puji4810/coffe-scale/mechanical/optimization/README.md

# 0.3.1 与 0.3.2 同步优化

**优先保留 0.3.1 一体盘，0.3.2 作为对比候选。** 原版本和用户修改均保留。优化版用同一份最新 PCB 快照、相同底架、脚座、限位与密封方案，避免把不同底部安装条件误当成上托架的性能差异。

两版对比

## 这轮实际改动

| 项目 | 0.3.1 优化版 | 0.3.2 优化版 |
|---|---|---|
| 上部结构 | 一体盘中梁由 8 加宽至 12 mm；增加两道 4 mm 宽、6 mm 高横筋 | 保留连续宽板，四个凸台凹槽底面降低 0.2 mm |
| Z 向承压基准 | 原加载端转接板与一体盘 | 宽板上平面为承压基准；凸台底面不再抢先触底 |
| PCB 安装 | 同步实板三个 Ø2.2 孔、M2×6 与铜嵌件 | 相同 |
| 主板托盘 | 板下空隙 4 mm；托盘由四个 M3 固定 | 相同 |
| 底架 | 固定端 3 mm 垫块并入 4 mm 底架，成为一体台阶 | 相同 |
| 脚座 | 顶端嵌入底架 1.5 mm；M3×6 名义啮合 3.5 mm | 相同 |
| 向下限位 | 加 M4 锁母与 Ø5 平接触头 | 相同 |
| 抬起/横向约束 | 四个肩销与固定支耳，正常量程不接触 | 相同 |
| 外观/密封 | 保留独立显示区、玻璃、Type-C 和底盖密封 | 相同 |

主体仍为 **160 × 140 × 53.3 mm**，含侧面 USB 塞盖宽 164 mm。没有通过减少正常活动间隙来换取“刚度”。

## 0.3.1 的安装孔已同步

读取的是实时 PCB 文件，并单独保存到 [本轮 PCB 快照](references/pcb-snapshot.json)，SHA-256 为 `e73e32f7bf9a52d882affaa53008e27e2d4c2059895e2c6f3d3852744153c337`。没有改动 PCB。

| 孔 | KiCad XY / mm | 装配 XY / mm | 钻径 |
|---|---|---|---|
| MH1 | (4,4) | (61,−41) | 2.2 mm NPTH |
| MH2 | (18,37.5) | (47,−7.5) | 2.2 mm NPTH |
| MH3 | (71,37) | (−6,−8) | 2.2 mm NPTH |

PCB 仍在梁前偏右，板底 Z=11；打印托盘上表面 Z=7。使用三个 M2×6、OD3.2×4 的铜嵌件包络及对应支承台；嵌件具体型号、热熔底孔和焊盘禁碰区要按实物复核。四个托盘安装点对应底架 M3 螺纹底孔 Ø2.5。

本轮“开孔位”按 PCB 安装孔及托盘/底架配合孔处理。USB、屏幕窗口沿用已保留的 0.3.1；连接器仍是采购包络，没有借此宣称其开孔已按供应商料号定稿。

## 关键装配细节

关键剖面

### 一体固定端底架

把原先 24×30×3 的固定端垫块与底架合为一个铝件，保留传感器高度和 M6 孔位，减少一个接触界面。成品主体轨道仍厚 4 mm，局部台阶总高 7 mm，需从至少 7 mm 厚毛坯铣削；不再能仅用一张 4 mm 平板切割完成。加工成本会增加，安装平面的平面度和紧固条件仍需实物确认。

### 脚座有效螺纹

脚座上端坐到铝底架的 1.5 mm 深沉台中，保留现有 M3×6：头部支承面 Z=4，螺钉端 Z=−2，脚座顶 Z=1.5，因此名义啮合 **3.5 mm**。

模型包含盲孔钻尖，其最深处到脚座底面还留 **1.25 mm**。肩台由 0.5 加厚到 1.5 mm，脚垫由 4 改为 3 mm，使脚底仍在 Z=−8、整机高度不变。穿过底盖的位置及其密封面保持原位。材料、有效螺纹、拧紧条件和脚垫最终 SKU 仍需验证。

### 0.3.2 的凸台避空

盘底凸台最低点 Z=36，托板对应沉腔底面改为 Z=35.8；四处实际 CAD 间隙均检查为 **0.2 mm**。这样由宽板上平面接盘底承担 Z 向定位，凸台底面留空。0.2 mm 是公差设计起点，应保证最坏公差组合下仍不触底。

盘面 M4 保留原 4 mm 名义啮合，加载端 M6 保留 6.5 mm 名义啮合；未为了增加螺纹而进一步削薄盲孔上方的铝材。反复拆装时的螺纹耐久、平面贴合和预紧仍要用实物评估。

### 限位与防抬起

- 向下：保留 **0.8 mm** 模型间隙，调整柱增加锁母与 Ø5 接触鼻；金属柱底部有连接到底架的螺纹柱包络。
- 抬起：四个定制肩销的头部与固定支耳底面相隔 **1.5 mm**。
- 横向：Ø4 肩杆穿过 Ø4.8 固定孔，径向名义间隙 **0.4 mm**。
- 肩销中心位于 X=±71，Y=−9/53；肩长 12.5、上部 M3 螺纹名义啮合 3.5、头部 Ø6×3。肩台拧紧在**可动盘凸台**上，不夹紧固定支耳。

肩销是本轮定制件包络，不是宣称现成 M3 螺钉可直接替代。固定支耳、细凸台和肩销的冲击承载尚未验证。上述三个间隙都不是 LC1330 已确认的允许位移：应测正常量程、偏载、温度和公差后的实际运动，再依据厂家允许载荷/位移设定。当前刚性平移检查也不等于传感器转动、倾斜和跌落仿真。

四脚按同一平面建模，尚未增加独立调平脚；样机需检查共面度，必要时使用固定侧薄调平垫片。限位锁母需要开盖操作，本轮没有实现不拆壳的外部调整。

## 装配顺序

1. 在壳外完成加载端、转接板/宽板、铝盘的装配；检验承压面，再按胶工艺粘玻璃。
2. 把上部子装配与固定外壳对位，**底架和电子件尚未装入时**，从底部安装四个防抬起肩销。已检查 Ø6 的直线装入通路不被固定壳体螺柱阻挡。
3. 组装脚座、底盖、底架、主板托盘和电子件，从开放底部进入壳体；通过原密封检修口装传感器固定端 M6。
4. 校准向下限位、锁紧，核对肩销正常悬空与线束松弛，再装底盖密封圈、检修盖、脚垫和 USB 塞盖。

底架固定端的一体台阶改变了零件 BOM，但保留原固定端底部工具路径。肩销、上盘和电子件仍需按此顺序维护，不应把最终静态无干涉理解成任意顺序都能装入。

## 如何决定用哪版

当前优先选择 **0.3.1 优化版**：它保持单件承重盘，补筋后仍比 0.3.2 轻。0.3.2 只有在相同条件下，角部挠度、稳定时间、回零或偏载表现出现可重复且有价值的改善时，才值得承担额外重量与装配要求。

| 本轮模型计算 | 0.3.1 优化版 | 0.3.2 优化版 |
|---|---:|---:|
| 可动铝件质量 | 278.47 g | 320.21 g |
| 可动总成估算质量，含玻璃、胶及紧固件 | 359.11 g | 400.34 g |
| 中部 X=0 截面绕 Y 轴的截面二次矩，不计玻璃 | 4533.53 mm⁴ | 5154.33 mm⁴，理想完全复合 |

0.3.2 可动铝件增加约 42 g（15%）；选定截面的理想截面二次矩增加约 14%。这只是一个位置、一个弯曲方向的几何对比，且 0.3.2 依赖连接面完全传递剪力、无滑移或张开，不能据此判定整体刚度优劣。当前没有证明其有足够性能收益来替代 0.3.1。

比较时固定同一传感器、玻璃、底架、脚垫、电子件、固件、安装扭矩、温度和校准方式。中心、四角及四边中点分别加载 500/1000/2000 g，各点之间回中心，不逐点重新标定。分开记录盘面位移、称重位置差、回零、稳定时间和重复性；加测热杯与拆装复现。

本轮保存中部 X=0 截面的几何比较，0.3.2 按完全复合的理想截面计算，不能直接换成整机刚度提升或克数精度改善。结果见 [comparison.json](../exports/optimization/comparison.json)。

## 输出与复现

| 文件 | 0.3.1 优化版 | 0.3.2 优化版 |
|---|---|---|
| 完整装配 | [STEP](../exports/v031-optimized/assembly.step) | [STEP](../exports/v032-optimized/assembly.step) |
| 承重盘 | [一体盘 STEP](../exports/v031-optimized/integrated_pan.step) | [盘面 STEP](../exports/v032-optimized/pan_cover.step) |
| 宽板 | — | [宽板 STEP](../exports/v032-optimized/wide_support.step) |
| 主板托盘 | [STEP](../exports/v031-optimized/pcb_carrier.step) | [STEP](../exports/v032-optimized/pcb_carrier.step) |
| 底架 | [STEP](../exports/v031-optimized/lower_frame.step) | [STEP](../exports/v032-optimized/lower_frame.step) |
| 验证报告 | [JSON](../exports/v031-optimized/validation.json) | [JSON](../exports/v032-optimized/validation.json) |

```bash
mechanical/.venv/bin/python mechanical/optimization/model.py --variant v031
mechanical/.venv/bin/python mechanical/optimization/model.py --variant v032
mechanical/.venv/bin/python mechanical/optimization/compare.py
mechanical/.venv/bin/python mechanical/optimization/render_review.py
```

正常构建使用本轮快照。明确同步 PCB 才执行 `capture_pcb.py`，它只写本目录快照。`baseline/` 与 `v032_reference/` 是保留依赖，仅供导入；不运行其旧导出入口。原版源码校验清单在 [preserved-sources.json](references/preserved-sources.json)。

验证覆盖所有实体有效性和连通性、零件体积干涉、指定向下/抬起/横向平移、肩销安装通路、0.3.2 凸台避空、顶部剩余连续材料、底盖密封圈及承压面、天线主要铝件避让，以及 STEP 回读实体数和体积。电子件高度仍为包络；没有 FEA、密封性能、热漂、冲击强度或称重精度认证。
