puji4810/coffe-scale/mechanical/optimization/v032_reference/README.md

# v0.3.2：参考宽板结构与三孔 PCB 安装

**这是依据参考图制作的可比较版本，保留用户修改后的 0.3.1；没有覆盖旧模型、旧快照或 PCB。** 保留 LC1330、玻璃盖板、固定显示区、下沿非接触搭接、Type-C 密封件及底盖密封。

装配预览

## 这种板能否替代四叉结构

可以把窄臂托架改成连续宽板，但本项目 0.3.1 的上承重件已经是一体带筋盘，并非最早的四条平臂。因此，0.3.2 实际比较的是：

| 项目 | 用户修改后的 0.3.1 | 0.3.2 候选 |
|---|---|---|
| 上部承力结构 | 盘面、底筋同体 + 小转接板 | 连续宽板 + 独立连续盘面 + 加载端垫块 |
| 与 LC1330 的连接 | 原加载端 M6 | 同一加载端 M6，未改传感器 |
| 左右偏置 | 53 mm | 仍为 53 mm |
| 可动铝件估重 | 259.33 g | 319.84 g，约增加 60.51 g |
| 顶面与玻璃 | 连续顶面、玻璃只粘可动侧 | 保留 |
| 下底架 | 矩形减重骨架 | 沿用，局部修改主板托架螺纹底孔 |

宽板可以提供不同的弯曲、扭转载荷路径，浅铣腔保留板面连续性。但厚度、材料、孔位、板与盘面的连接平面度都会影响结果；仅凭照片不能说它比现有一体带筋盘更硬或更准。参考图没有给厚度、材料或刚度数据。

**宽板不会消除偏心力矩。** 图中总长 185，加载孔组距右端 39，因此孔组相对外形中点的偏置为 `185−39−185/2=53.5 mm`。这是托板外形中点，不一定等于原产品实际秤面中心。我们的盘中心 `(0,13.5)`、加载孔组中心 `(53,15)` 未变，3 kg 集中载荷放在盘中心时，相对孔组仍约产生 1.56 N·m 的力矩，尚未计可动自重。不能直接把该数换算成克数误差。

单点式传感器的偏载补偿与平台适用条件是传感器自身的重要特性；例如 [HBK 官方 PW2D 说明](https://www.hbkworld.com/en/products/transducers/load-cells/single-point/pw2d) 分别列出扭转刚度、偏载补偿和适用平台。这里引用其原理，不把别的型号指标当作 LC1330 的性能保证。

## 宽板尺寸与盘边支承

托板与 PCB 尺寸

图中 185 mm 长度无法直接放入 160 mm 机身，本版按结构思路重新设计，**没有等比例缩放 LC1330 孔距**。

| 项目 | 当前名义尺寸，mm |
|---|---|
| 宽板外廓 | 138 × 84，两端展开、中间连续宽板，轮廓过渡 R3；圆角会削去外廓尖点 |
| 板厚与位置 | 厚 9，Z=32..41 |
| 中部板身宽度 | 54 |
| 底部浅铣腔 | 80 × 40、深 5，R5；剩余上层 4 |
| 加载端连接 | 2 × Ø6.6，孔组间距 15，X=53、Y=7.5/22.5 |
| M6 沉孔 | Ø11、深 6.5，承压底厚 2.5 |
| 加载端垫块 | 24 × 30 × 3，Z=29..32 |
| M6 螺钉 | M6×12 圆柱头，名义进入传感器 6.5；头顶到盘底 0.5 |
| 盘面安装孔 | 四处 Ø4.4 通孔，孔距 118 × 60；中心 X=±59、Y=−15/45 |
| 盘面固定 | 从下方用 M4×8 拧入盘底一体凸台，名义啮合 4 |
| 盘面 | 160 × 113、名义顶层厚 3，下翻边沿用；局部盲孔含钻尖后仍留至少 2 mm 连续顶层 |
| 玻璃及整机 | 沿用 159 × 112 × 1.1 玻璃；主体 160 × 140 × 53.3；含 USB 塞盖宽 164 |

盘底四个凸台进入宽板的 Ø12.4、深 5 mm 定位避让腔，间隙径向 0.2 mm。盘面下表面还与宽板上平面贴合，不只是四个螺钉点承重；这种贴合是否稳定，需加工平面度与装配检验支持。M4 盲底孔直段深 5 mm，模型另包含 1 mm 钻尖，未建真实螺纹。

**支架不必伸到秤盘最外角。** 四个螺钉中心到盘外框的距离：左右各 21，前 28，后 25；它们不是全部接触面的边界。宽板实体比孔位更向外伸，剩余盘边由 3 mm 铝顶层和下翻边跨出承载。参考图那种内收支承可以采用，代价是必须检查外伸盘面的局部挠度和杯底/角部受力。

不要用玻璃单独承担悬空角载，也不能只用支架孔距判断整机四角误差。本版没有 FEA；质量增加约 61 g，也会减少 LC1330 可用净载荷余量。是否优于一体盘，需要相同玻璃、安装扭矩、载荷和温度条件下的对比试验。

## PCB：三个真实 M2 孔，梁前偏右

新快照直接读取 `pcb/scale-adc-s3/scale-adc-s3.kicad_pcb`，只写入本版本的 `references/pcb-snapshot.json`。捕获的 SHA-256 为 `e73e32f7bf9a52d882affaa53008e27e2d4c2059895e2c6f3d3852744153c337`，板外形 75 × 40、厚 1.6，三孔为 **Ø2.2 NPTH**。

坐标变换沿用 `X=65−KiCad_X，Y=−45+KiCad_Y`；板底 Z=11，板边范围 X=−10..65、Y=−45..−5。该位置使主板与 LC1330 在前后方向相隔 5 mm，左前方留给电池，显示屏仍在前部固定侧。没有为了换支架而无依据地旋转主板。

| 安装孔 | KiCad 坐标 | 装配坐标 |
|---|---|---|
| MH1 | (4,4) | (61,−41) |
| MH2 | (18,37.5) | (47,−7.5) |
| MH3 | (71,37) | (−6,−8) |

用户在 0.3.1 已加入三孔安装，本版继承并进一步调整：

- 打印托盘底板从 Z=8 降到 Z=6，板底到托盘上表面留 **4 mm**，为背面焊点和引脚留余量；实际 THT 引脚长度仍需实板确认。
- 三处 Ø5.4 支承台接触主板孔周区域，使用 M2×6 和 OD3.2 × 4 的铜嵌件包络；嵌件具体料号、底孔及热熔过盈待选型。绝缘支承环及螺钉头下方需复核 PCB 禁布区。
- 托盘自身用四个 M3×6 与 2 mm 隔柱固定到底架；对应底架孔改成 M3 螺纹底孔 Ø2.5，名义啮合 3 mm。
- 保留天线前方的结构避让。CAD 对主要铝承力件检查沿用的天线禁入体积；这不等于全部电池、线束和屏蔽件完成射频验证。
- 新快照提取了 74 个器件的二维制造层包络，纳入装配干涉检查。高度仍是预留值；连接器已插线外形、弯线半径和精确 STEP 未获得。
- J5 到侧面密封 Type-C 仍需内部短延长线，J7 接屏幕，J2 接传感器。线束不可牵拉可动盘，最终线头与走线必须再核对。

## 验证及装配

验证输出见 [validation.json](../exports/v032/validation.json) 与 [STEP 回读](../exports/v032/step-roundtrip.json)。包含全零件有效性/连通性/两两体积干涉、刚性下移 0.4/0.8、底盖密封圈及压紧面连续性、顶部剩余 2 mm 连续材料、下方 M4 工具接近路径和天线铝件避让。

传感器只是包络，移动垫块与传感器加载端的贴合面在下移检查中排除，因为真实加载端会一起移动；其他可动件对传感器包络仍检查。宽板到传感器顶部空载 3 mm，下移 0.8 后为 2.2 mm；四个止挡到盘面仍为 0.8 mm。限位值是模型初值，不是已校准的过载保护位移。

装配时先在壳外用 M6 将宽板和垫块装到加载端，再从下方用四颗 M4 固定连续盘面，随后接入底架与固定侧电子件。M4 工具通路检查不包含尚未安装的 PCB，维护时可能需要先拆主板托盘。玻璃、USB 与底盖的装配/检漏边界沿用 0.3.1。

样机应对比中心、四角和四边中点的 500/1000/2000 g 载荷、盘边位移、回零、重复性与热杯漂移；各点之间不重新标定，并在点测前后回到中心。几何检查通过不能证明更好的力矩补偿或 ±0.2 g 精度。

## 运行与文件

```bash
# 正常构建使用本版本已冻结的 PCB 快照。
mechanical/.venv/bin/python mechanical/v032/model.py
mechanical/.venv/bin/python mechanical/v032/render_review.py

# 明确要同步新的 PCB 时才执行；仍不会写 PCB 或旧版快照。
mechanical/.venv/bin/python mechanical/v032/pcb_capture.py
```

- [完整装配 STEP](../exports/v032/assembly.step)
- [宽板托架 STEP](../exports/v032/wide_support.step)
- [连续盘面 STEP](../exports/v032/pan_cover.step)
- [主板托盘 STEP](../exports/v032/pcb_carrier.step)
- [PCB 含真实孔位 STEP](../exports/v032/PCB_ENVELOPE.step)
- [修改后的底架 STEP](../exports/v032/lower_frame.step)
- [参考图](references/support-reference.png)

`base/` 保存本次开始时用户修改后的 0.3.1 源码，仅供本版导入；不应运行其中的旧导出入口。基线校验清单见 [baseline-manifest.json](references/baseline-manifest.json)。这样后续继续修改原 0.3.1，也不会悄悄改变 0.3.2 的依赖。
