puji4810/coffe-scale/mechanical/glass-and-sealing.md

# v0.3.1：在 v3 上增加玻璃、Type-C 和底盖密封

本版保留 v0.3 的一体铝承重盘、固定前显示区、下沿搭接缝和 LC1330 安装方式。玻璃仅覆盖可动盘；没有采用整机连成一片的顶盖。新增代码位于 `sealed_assembly.py`，原 `assembly.py` 和 `exports/v03/` 仍可复现 v3。

## 玻璃盖板

| 项目 | 建模尺寸 / 处理 |
|---|---|
| 玻璃 | 159 × 112 × 1.1 mm，圆角 R5.5，四周比铝盘内缩 0.5 mm |
| 底部胶层 | 0.2 mm，连续覆盖，只连接玻璃与可动铝盘 |
| 玻璃上表面 | Z=45.3 mm，比 v3 增高 1.3 mm |
| 质量 | 按密度 2.5 g/cm³ 估算约 49 g，具体值见验证报告 |
| 承力 | 玻璃 → 胶层 → 一体带筋铝盘 → 转接板 → LC1330 |

玻璃由铝盘连续支承，采用磨边、倒钝的盖板玻璃；可询价化学强化玻璃，具体牌号、工艺和厚度公差待供应商确定。化学强化用于盖板的原理见 [Corning 官方说明](https://www.corning.com/worldwide/en/innovation/the-glass-age/science-of-glass/how-it-works-strengthening-glass.html)，这里没有指定必须采购该品牌，也不把强化等同于不会破裂。

胶层按连续柔顺层预留，避免局部垫块让玻璃悬空或边缘积液。胶的模量、耐水、耐温、固化收缩，以及玻璃与铝的热变形差异需要实物联调。杯底热冲击、边缘撞击与粘接后的回零/蠕变要重新测试。**胶、玻璃均不能跨到固定屏幕面板或外壳上。** 新增可动自重也应计入传感器量程余量，去皮不会增加机械额定载荷。

## 底盖：外沿退让，内圈压紧

底盖厚 2.5 mm，Z=−3.5..−1；固定壳体底部增加连续法兰，底盖与法兰的实体接触面控制压紧终点。

- 周边密封圈外形 158 × 138、内形 154 × 134，宽 2 mm；完整闭合。
- 自由厚度暂定 1.0 mm，装配包络 0.8 mm，对应 20% 名义压缩；这个数是可修改的设计起点，**需按最终材料数据和样件压缩力确认**。
- 法兰有 0.8 mm 深槽，底盖压到实体止口后不继续挤压密封圈。需控制槽深、底盖挠曲、表面平整度和打印孔隙；不能只靠拧紧扭矩判断密封。
- 底盖外沿最外侧 0.6 mm 宽区域下退 0.3 mm，另有向外的排水退让。它们在周边密封圈之外，不直接贯通电子件内腔。
- 四处 M3×10 固定点位于 `(±72.5,±30)`，使用固定侧盲孔柱；螺钉头下另有环形密封槽和垫圈，封住位于周边密封圈内的穿孔。
- 每个脚座穿孔也单独加环形面密封。金属肩台抵住底盖的实体面，密封件装在槽内，不作为承重软垫。

四个金属脚座上端接触原铝底架、下端接橡胶脚垫，主承力路径不依赖薄打印底盖的弯曲刚度。模型保留四个脚垫 4 mm 厚，脚垫底端移至 Z=−8 mm。因此加玻璃及底盖后的 **整机总高 53.3 mm**；原 v3 为 48 mm。

脚座暂定金属车削件，中心盲 M3 孔、M3×6 螺钉名义旋入 2 mm；需要按最终脚座材料、有效螺纹和拧紧要求复核，不能直接按简化孔加工。四个底盖螺钉、四个脚座均画出穿孔密封，但具体密封件截面、硬度和压缩率尚未选定。

底盖密封并未把上方非接触称重缝变成水密封。保留 v3 的上部挡水和排水结构，整机仍需做泼溅验证，不能据此浸泡或冲洗。

## Type-C：三处需要分别处理

| 部位 | 当前模型 |
|---|---|
| 外壳与接口法兰 | 独立面密封圈，外形 18 × 13、内孔 14 × 9，装配厚 0.5 mm |
| 插座本体背部 | 要求密封封装/灌封的 USB-C 数据与供电延长组件；当前为采购包络 |
| 未插线时的口部 | 可拆硅胶塞盖，带插入段与面密封凸缘，图中是闭合压缩状态 |

沿用右侧位置，接口中心调整到 `(Y=−51,Z=16.5)`，避开壳体前角并留出完整密封面。壳体孔暂定 13 × 7；法兰 26 × 15、厚 2 mm；两颗 M2×6 沉头螺钉位于主密封圈之外，拧入壳体盲孔。固定侧局部加厚支承，不在 PCB 上开孔。

塞盖闭合时外侧到 X=84，因此主体仍为 **160 × 140 mm**，含侧面塞盖的整体包络为 **164 × 140 mm**。这种外置塞盖便于拆装，尚未做系绳或防丢铰链。插入段以压缩后的名义外形表达，实际保持力、过盈、磨损和材料硬度需实测。

这是小型密封延长件的空间目标，不是现成 USB 料号的精确 STEP。不可按本模型自行制造 USB 触点或直接下单开孔；应取得具体连接器、插头、短线和后部封装尺寸后替换 `usb_cassette_ENVELOPE`。内部线束仍接现有 PCB，线头、弯曲半径和完整走线尚未建模。

密封连接器通常分别规定配套插合状态与塞盖闭合状态，例如 [Bulgin 官方连接器说明](https://www.bulgin.com/en/products/range/pxp4043-c-series-rear-panel-mount-c-type-micro-usb-1.html)。引用仅用于说明这些状态需分别验证，不表示本模型匹配该产品的尺寸或具有其认证。**取下塞盖插普通 USB 线时，本方案不宣称防水。**

板上 USB 座 J5 实际位于机械坐标 `(X=19, Y=−10)`，开口朝 +Y（机内方向），不在任何外壁上——所以右壁插口盒必须通过内部短线转接，估算走线约 65–70 mm；线束两端固定方式与弯曲半径仍需实物规划。

## PCB 固定孔

PCB 文件已放入 3 个 M2 非金属化孔（Ø2.2 NPTH），`pcb_snapshot.py` 重新抓取后结构自动跟随——孔位若再移动，重跑 `pcb_snapshot.py` 和两个装配脚本即可，**不要手改机械侧坐标**。

| 孔位 | KiCad 原生坐标 | 机械坐标 |
|---|---|---|
| MH1 | (4, 4) | (61, −41) |
| MH2 | (18, 37.5) | (47, −7.5) |
| MH3 | (71, 37) | (−6, −8) |

- 托架在三个孔位各加 Ø5 凸台，把板从 1 mm 底板上垫起（凸台 Z=9..11，板底 Z=11）；侧边保留 1 mm 边缘定位座辅助落板。
- 螺钉按 M2×8 自攻包络建模（简化牙芯 r0.75），凸台开 Ø1.6 过孔导孔并贯通底板。若改用 M2 机牙+嵌件，凸台外径和孔径要相应调整。
- NPTH 孔周围的铜皮/走线避让由 PCB 侧保证；MH3 凸台螺钉头与 J9 包络的名义间隙只有约 0.3 mm，若 J9 选型或孔位变动需复核。
- 当前孔位是三点不对称布局，满足定位；若量产要防呆/更好支撑可再在 PCB 上调整，机械侧随快照自动同步。

## 装配与维护

1. 在壳外完成 v3 的传感器、转接板与铝盘装配，再按胶的工艺粘玻璃；检查胶没有跨接固定侧。
2. 先将 USB 面密封圈、延长组件、螺钉和内部短线装入壳体，核对面密封连续压紧；装闭合塞盖。
3. 在底盖上装脚座密封圈和金属脚座，将铝底架用脚座螺钉固定，再装电子件；脚座固定后检查底盖可拆性与线束余量。
4. 将周边圈放入壳体槽内，装底盖和四颗带头下密封的 M3 螺钉，逐步对角压到止口。
5. 调整限位、检查自由回零；最后装脚垫并进行检漏、热杯和九点称重试验。

当前只检查最终装配和指定直线间隙，不是全装配路径仿真。打印外壳需对密封面精加工或采用经验证的后处理，平面密封圈、脚座密封和接口密封应能拆换。没有提供量产拧紧扭矩或防水等级。

## 复现与输出

```bash
mechanical/.venv/bin/python mechanical/sealed_assembly.py
mechanical/.venv/bin/python mechanical/sealed_assembly.py --frame butterfly
mechanical/.venv/bin/python mechanical/render_sealed.py
```

当前输出目录：`exports/v031/{rectangle,butterfly}/`。装配 STEP、玻璃、底盖、修改后的壳体/底架、密封件与 USB 包络分别导出；旧 v3 输出保留不覆盖。

验证包括：全部零件实体有效性、连通性、两两体积干涉；可动件下移 0.4 / 0.8 mm 后的固定件干涉；原天线铝件避让；周边密封圈连续性与上下支承面；STEP 回读实体数和体积。密封件按压缩状态建模，这些检查不能证明密封压力、无泄漏、玻璃强度或称重准确度。
