puji4810/coffe-scale/mechanical/pan-design.md

# v0.3：连续顶面的一体带筋承重盘

盘面、底筋和下翻边由同一块铝材加工，顶部不留贯穿螺钉孔。下翻边包住固定壳体内缩的挡水立边，让活动开口朝下；前缘覆盖与固定显示区的分界。

一体盘正反面

## 1. 结构与高度

| 项目 | 候选尺寸，mm |
|---|---|
| 秤盘平面 | 160 × 113，外圆角 R6；X=−80..80，Y=−43..70 |
| 盘体总深 | 11，Z=33..44 |
| 连续顶层 | 厚 3，Z=41..44 |
| 加强区域 | 134 × 96；底面铣腔深 8，保留周边筋、中梁和加载端安装台 |
| 下翻边 | 厚 2，高 5，Z=36..41，与顶层同体 |
| 转接板 | 28 × 56 × 4；中心 (53,15)，Z=29..33 |
| LC1330 | Z=7..29，外形与原孔型不变 |
| 固定端垫块 / 底架 | Z=4..7 / Z=0..4 |
| 脚垫 | Z=−4..0；整机总高 48 |

铝材候选为 6061-T6；薄顶层加工平面度、装夹和残余应力处理需加工方确认。所有深度均是概念名义尺寸，尚未出含公差的加工放行图。

按 CAD 实体体积、密度 2.70 g/cm³ 估算，盘体 **243.82 g**，转接板 **15.50 g**，合计 **259.33 g**。旧 v0.2 的秤盘、托架、垫块合计 303.77 g，本版减少 **44.44 g**，均不含紧固件。记录见 [pan-review.json](exports/v03/pan-review.json)；旧体积基线独立保存在 [v02-mass-baseline.json](references/v02-mass-baseline.json)，重新构建不依赖旧 STEP。

## 2. 把活动缝藏到下沿

挡水剖面

固定壳体顶面 Z=33，其上有一圈连续内缩立边，外形 152 × 105、壁厚 2、顶高 Z=38.5。外侧可动下翻边的底端 Z=36，形成无接触搭接。

| 间隙 | 空载模型 | 刚性下移 0.8 mm 后 |
|---|---:|---:|
| 下翻边内面到固定立边外面 | 2.0 | 2.0 |
| 下翻边底端到固定台阶 / 前面板 | 3.0 | 2.2 |
| 盘顶层底面到固定立边顶端 | 2.5 | 1.7 |
| 两道边的竖向遮挡重叠 | 2.5 | 3.3 |

侧面和后部的排水缺口位于内圈立边之外，实体检查确认没有切断内圈挡水边。图中蓝箭头表示期望的排水方向，未模拟水的附着、飞溅或毛细作用。

前方屏幕区域仍然固定，顶部另有一张 **152 × 28 × 0.3 mm 连续 PC 覆膜**，下面是 0.2 mm 闭合周边胶圈。覆膜覆盖屏幕和按键开口，只粘固定面板；后缘位于秤盘前缘下方，分界从上方被遮住。膜片按键组件、背面支撑和胶粘工艺待实物选型，按键接已有 J8；模型没有因此改 PCB。

**不能把整张膜、胶或橡胶圈跨接可动盘和固定面板**，否则会形成额外传力路径。连续秤面和非接触搭接用于降低上方泼水直接进入的机会，不等于水密封。USB 延长接口目前仍有开口，底盖和其他接缝也未完整密封，需完善后做实物泼溅、积液和清洁测试。

## 3. 顶部无孔，怎样安装

保留传感器原 M6 螺纹，用小转接板把传感器安装与秤盘安装分成两道连接。

| 连接 | 数量 / 候选螺钉 | 孔和名义啮合 |
|---|---|---|
| 转接板 → LC1330 加载端 | 2 × M6×12 圆柱头，从上拧入 | 转接板 Ø6.6 通孔，穿过 4 mm 板后名义啮合 8 mm |
| 转接板 → 一体盘 | 4 × M4×10 圆柱头，从下拧入 | 转接板 Ø4.4 通孔，盘底 M4 盲孔，名义啮合 6 mm |
| LC1330 固定端 → 底架 | 2 × M6×16 沉头包络 | 沿用固定端垫块和底架，实际头型、孔深和啮合需确认 |

盘底为两颗 M6 螺钉头预留 Ø11、深 6.5 的盲腔，腔顶至盘顶保留 4.5 mm；螺钉头与腔顶名义间隙 0.5 mm。四个 M4 孔中心是 `(47,−7)、(47,37)、(61,−7)、(61,37)`，直段底孔 Ø3.3、深 7，有效螺纹候选深 6.5。直段底孔上方还有 4 mm 材料，另预留约 1 mm 钻尖空间；加工方需核对实际钻尖和丝锥退刀需求，保证连续顶层不被钻穿。

螺纹在 CAD 中简化，实体不相交并不能验证螺纹承载、拧紧扭矩或拉脱强度。LC1330 外形与孔位来自 [厂家尺寸图](https://www.labloadcell.com/uploads/13301.jpg)，本地有 [原图](references/lc1330-dimensions.jpg)；固定端、加载箭头和孔内实际可用深度以手头实物为准。

### 装配顺序

1. 在壳外，把转接板用两颗 M6 固定到 LC1330 加载端。
2. 将一体盘盖到转接板上，让 M6 螺钉头进入盘底盲腔；翻转并从下方拧入四颗 M4。该步骤在 PCB 和底架安装前完成，CAD 已检查直径 5 mm 的直线工具接近通路。
3. 将盘 / 传感器子装配固定到铝底架的固定端垫块，从底部安装固定端螺钉。随后从开放底部装入电子件和外壳组件；显示覆膜可先在壳体上粘好。
4. 安装线束并保留传感器出线松弛弯，完成限位调整后再装脚垫与待设计底盖。主板最终卡扣、线头和壳体装入路径仍需样机核对。

前排 M4 下方有主板区域，维护时需要先拆电子件，不能把上述壳外工具通路理解为整机不拆卸即可维修。

## 4. 已检查与待实测

当前默认矩形底架和四叉底架对照装配均有 45 个有效实体，无体积干涉；STEP 回读实体数和体积一致。一体盘完整 3 mm 顶层、四处 M4 安装台、连续挡水边、前覆膜及壳外工具通路检查通过。刚性下移 0.4 / 0.8 mm 未碰到固定零件，0.8 mm 时止挡接触盘底。

0.8 mm 是限位布局初值，必须根据实物空载、满载中心 / 四角位移、公差及厂家允许过载位移调整，并落实锁紧。当前未设计抬起限位、横向冲击保护或运输锁；刚性平移检查不包含实际传感器旋转和盘体挠曲。

保留 LC1330 意味着加载端仍偏置 53 mm。一体带筋盘减少连接面，但不消除力矩，也没有证明达到 ±0.2 g；仍需按 [README 的九点测试](README.md#受力与验证边界) 检验整机偏载、重复性和回零。
