puji4810/coffe-scale/mechanical/support-design.md

# 上托架 v0.2：一体铣削带筋托盘

> 历史对照：当前方案已改为顶面无孔的一体承重盘，见 [v0.3 设计](pan-design.md)。本文与 `exports/upper-support/` 保留旧版独立秤盘结构，不作为当前装配尺寸。

## 设计结果

采用 **6061-T6 铝合金一体加工托盘**，上表面支承独立秤盘，底面两个连通轮廓的减重腔保留周边筋、中梁、加载端安装区域和四个秤盘螺钉安装台。没有额外接触固定底座；传感器加载端位置不变，偏心力矩仍然存在。

| 项目 | 候选尺寸 / 结构 |
|---|---|
| 托架外形 | 134 × 96 × 10 mm，外圆角 R6 |
| 上层厚度 | 3 mm |
| 底面铣腔 | 深 7 mm，所有平面轮廓内角 R3 |
| 周边筋 | 宽 4 mm，位于上层下方，高 7 mm |
| 中梁 | 宽 8 mm，同样高 7 mm；与上层形成局部 T 形截面 |
| 传感器连接 | 右侧两颗 M6，组内距 15 mm；下方保留 24 × 30 × 3 mm 垫块 |
| M6 安装孔 | Ø6.6 通孔，上面 Ø11 沉孔深 6.5 mm；承压底厚 3.5 mm |
| M6 螺钉 | 圆柱头 M6×16，简化头 Ø10 × 6 mm，名义啮合 9.5 mm |
| 秤盘固定 | 四颗 M3×8 沉头螺钉，孔距 122 × 84 mm；简化 Ø6 螺钉头低于盘面 0.5 mm |
| 托架 M3 孔 | M3×0.5，有效螺纹深 6 mm；Ø2.5 直段底孔深 8 mm |
| 秤盘孔 | Ø3.4 通孔，上面 Ø7、深 1.8 mm 的 90° 沉孔包络 |
| 整机尺寸 | 160 × 140 × 49 mm，比 v0.1 高 7 mm |

螺钉都用简化包络：螺纹、内六角和钻尖未建立。上托架 M6 头径参考 [Bossard 头部承压尺寸资料](https://www.bossard.com/nl-en/-/media/bossard-group/website/documents/technical-resources/en/f-040-en.pdf)；M6 圆柱头高度 6 mm 可在其 [ISO 4762 产品 CAD 目录](https://bossard.partcommunity.com/3d-cad-models/bn-31101-5403310-socket-head-cap-screw-m6x10-bossard-catalog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)核对。订购时仍以具体型号的头部公差、实际长度和传感器孔深确认装配。

### 为什么选这种形状

原四臂把 3 mm 平板沿长度方向悬伸，长臂对竖向载荷容易产生较大挠度。新托架用更深的截面，同时通过连续上层和周边结构连接四个支撑位置，增加分担载荷的路径。中梁从左侧延伸到右侧安装区域，周边筋把前后区域连接起来。

这仍是**底面开口的带筋托盘**，不宣称它是完整的闭口扭转箱。秤盘虽然固定在其上面，但计算时没有假定两者形成无滑移的复合板，也没有计算整体抗扭刚度。

一体铣削比单独焊接筋条更容易控制这个小尺寸件的安装面和装配关系。折弯件可以作为后续成本方案，但需要重设计接头、弯曲半径、避空和加工基准，不能直接把此 STEP 当作钣金展开件。

## 质量与截面对照

由实际 CAD 体积、假定密度 2.70 g/cm³ 计算：

| 方案 | 托架估算质量 | 说明 |
|---|---:|---|
| 原 3 mm 平板四臂 | 37.69 g | v0.1 几何原样保留 |
| 6 mm 平板四臂 | 76.04 g | 只作单件比较，没有集成到整机 |
| 新 10 mm 带筋托盘 | 171.63 g | 默认装配方案，比原托架重约 133.94 g |

这个版本优先探索更高刚度，尚未优化到最轻。增加的可动质量会占用传感器量程；加上秤盘、垫块和螺钉后，不能再把 3 kg 传感器当成允许额外放满 3 kg 的整机。去皮也不会恢复机械量程。

`support_review.py` 另计算局部竖向弯曲截面的面积惯性矩 I：

- 13 mm 宽 × 3 mm 厚平条：I = 29.25 mm⁴。
- 13 mm 宽 × 6 mm 厚平条：I = 234.00 mm⁴。
- **人为选取** 13 × 3 mm 上翼缘 + 8 × 7 mm 下筋的局部 T 形条：I ≈ 832.65 mm⁴。

计算使用矩形自身惯性矩 `b h³/12` 与平行轴项 `A d²`。在相同材料、长度和边界条件下，梁弯曲刚度与 I 成正比；这里的 13 mm 上翼缘宽度只是统一比较口径，并非板有效宽度分析。因此 **28.47 倍只是所选截面 I 的比值，不能称为整机刚度提高 28 倍，更不能换算为克数误差**。

尚无 FEA、网格收敛、角载挠度、局部承压、螺纹拔出或疲劳验证；也没有宣称四角误差达标。

## 加工与装配

1. 毛坯留精加工余量，加工上下基准面；成品托架总厚 10 mm。
2. 从底面铣两个深 7 mm 的腔，保留中梁、周边筋及四个斜角安装台。内角 R3 可供 Ø6 或更小刀具进入；轮廓已避免相邻口袋相切留下的薄尖筋。实际刀路、根部刀尖圆角与去毛刺由加工方确认。
3. 从上面加工 M6 通孔/沉孔和 M3 盲螺纹孔。M3 的 8 mm 底孔深度指直段，另考虑钻尖和丝锥退刀空间，禁止钻穿安装台。
4. 精加工秤盘接触面及传感器垫块接触面；接触面不得有毛刺、涂层堆积或靠拧紧螺钉强行拉平的翘曲。平面度、平行度与表面处理公差尚待加工图定稿。
5. 先安装传感器固定端与下垫块，再将右端上垫块和托架用两颗 M6 圆柱头螺钉固定。秤盘尚未装入时，内六角工具从上方进入。
6. 放上独立秤盘，以四颗 M3×8 沉头螺钉固定。当前 Ø6 简化头部与 Ø7 沉孔相配时，下沉 0.5 mm 后贴合锥面；名义进入托架 5.5 mm，小于 6 mm 有效牙深，底孔另留余量。实际头径变化会改变沉入深度，需核对避免顶到孔底。
7. 统一装配后检查间隙，再通过加载试验调整和锁定四个限位。

不要沿用任意扭矩表直接拧紧：M6 拧紧条件需同时满足 LC1330 供应商要求及托架局部承压能力。更换螺钉头型、加垫圈或表面处理会改变当前 0.5 mm 的头顶余量，应重新校核。

## 当前验证结果

两个底架版本均使用新托架，通过：

- 44 个实体的有效性、单件连通性及两两实体干涉检查。
- 可动组件整体下移 0.4 mm 和 0.8 mm 时，与固定件无体积相交。这是装配行程检查，不是受力仿真。
- 托架到传感器本体：静态 3.0 mm；下移 0.8 mm 后仍有 2.2 mm。
- 秤盘到固定外壳最小距离 2.0 mm；限位空载间隙 0.8 mm；M6 螺钉头顶到秤盘 0.5 mm。
- 主板/接插件占位与新结构无体积相交，铝件没有进入当前天线避让体积。
- M3 孔周围保留完整深度的材料、底孔封闭；装秤盘前 M6 工具路径畅通。
- 导出整机 STEP 后回读，实体数、有效性和总体积一致。

0.8 mm 限位仍是占位设定，电子件仍是包络。线束、胶层、实际公差和传感器运动形态尚未包括在验证中；最终需按 README 的九点测试计划验证偏载、重复性与回零。

## 文件与复现

- `upper_support.py`：托架几何，保留 `flat_reference()` 作为原版对照。
- `dimensions.py`：`upper_*` 参数、安装点及随托架厚度更新的整机高度。
- `exports/rectangle/upper_spider.step`：默认新托架单件；使用旧文件名以延续装配引用。
- `exports/rectangle/assembly.step`：新版完整装配。
- `exports/upper-support/ribbed_10mm.step`：明确命名的新托架单件。
- `exports/upper-support/support-comparison.png`：原四臂与新托架底面预览。
- `exports/upper-support/support-drawing.png`：底面特征投影、截面和孔位审阅图。
- `exports/upper-support/comparison.json`：质量、局部截面计算与安装台检查结果。

```bash
mechanical/.venv/bin/python mechanical/assembly.py
mechanical/.venv/bin/python mechanical/assembly.py --frame butterfly
mechanical/.venv/bin/python mechanical/support_review.py
mechanical/.venv/bin/python mechanical/render.py
mechanical/.venv/bin/python mechanical/render_support.py
```

所有修改位于 `mechanical/`，PCB 继续使用已存只读快照。
