puji4810/coffe-scale/mechanical/optimization/v032_reference/structure-review.md

# 0.3.1 / 0.3.2 结构复核

## 结论

0.3.2 具有提高局部抗弯截面性能的潜力，不能据此宣称整机刚度或称重性能更好。0.3.1 已是一体带筋盘，不是最早的薄四叉臂。0.3.2 的两件大平面连接、偏载扭转和下底架响应尚未验证。

### 当前 CAD 的局部截面计算

在 X=0 取 0.1 mm 均匀薄片，从 CAD 体积惯性矩换算截面二次矩 I_y，衡量该处沿 X 方向承受竖向弯曲的几何抗弯能力；同材质局部梁近似中 EI 与它成正比。

| 截面 | I_y / mm⁴ |
|---|---:|
| 0.3.1 一体带筋盘 | 3908 |
| 0.3.2 宽板单件 | 1504 |
| 0.3.2 连续盘面单件 | 598 |
| 0.3.2 两件完全复合的理想截面 | 5154 |

两件完全复合时，此截面指标约增加 32%，可动铝件从 259.33 g 增至 319.84 g（增加约 23%）。这是局部的理想化几何比较，不是整机刚度提高 32%，也没有证明重量效率更高。两件各自截面 I 相加为 2102 mm⁴，仅用于说明复合作用的重要性，不是实际装配刚度下限。

真实连接可能发生接触面的开合、微滑和不均匀承压；四角加载还涉及扭转与板弯曲。玻璃与胶层、螺钉预紧、传感器弹性和下底架没有进入该截面计算。极惯性矩也不能直接当作这种开口薄壁结构的扭转常数。

复现：`mechanical/.venv/bin/python mechanical/v032/section_review.py`。数据见 [section-review.json](../exports/v032/section-review.json)。没有修改任何 CAD 尺寸。

## 优先改善项

### 1. 明确托板与盘面的唯一 Z 向承压基准

当前盘底凸台高度 5 mm，托板沉腔深度也为 5 mm；设计同时要求宽板上平面贴盘底、四个凸台端面贴沉腔底。加工公差或翘曲可能让凸台先触底，导致本应大面积接触的平面悬空。

建议以宽板上表面的指定平面承压，凸台只用于螺纹连接和侧向避让，底面留出额外轴向空隙。可从 0.1–0.2 mm 的名义避空开始做公差链，最终数值由加工能力确定；不能简单把四处都做零间隙。螺钉预紧、平面度、贴合检查及装配后回零需写入装配要求。

若希望结构最可预测，可将宽板思路融合回一体带筋盘，减少这处大面积螺接界面的不确定性。是否采用取决于加工成本和样机对比，不因新版本编号而默认它更优。

### 2. 加强材料分布，先检查固定端底架

优先研究保留较高的周边筋、加载端到远端的连续筋，以及靠盘前后边缘的纵向承力路径，再决定哪里减重。不要为了减重挖断扭转载荷路径，也不要把整片继续加厚作为唯一手段。

固定端 24×30 mm 垫块、4 mm 铝底架、底架开窗附近与脚座连接需要一起评估。刚度不足或安装面不平会改变安装状态；[HBK 的载荷引入与支承说明](https://cloud.hbkworld.com/en/knowledge/resource-center/articles/load-application-in-load-cells) 强调安装接触点和刚性基座的重要性，具体 LC1330 扭矩仍应使用其供应商要求。

四脚结构需保证共面，或提供调平能力，避免在不平台面上靠扭曲底架实现四脚接触。这里不把打印底盖或软密封圈作为传感器主支承。

### 3. 核实紧固件有效啮合与加工面

当前模型名义值：盘面 M4 啮合 4 mm、传感器加载端 M6 啮合 6.5 mm、金属脚座 M3 啮合约 2 mm；M6 沉孔承压底厚 2.5 mm。这些都只是几何候选。

优先增加脚座可用有效螺纹长度，并按实际材料、孔深、钻尖/丝锥退刀和螺钉头标准复核。盘面频繁拆装时可评估钢丝螺套或更深的螺纹台，但不应侵入玻璃粘接面。不要把其他厂家的 M6 拧紧扭矩套用到 LC1330。

### 4. 限位从占位尺寸变成可调、可测结构

0.8 mm 当前只是 CAD 间隙，没有来自传感器满载位移。需要先测带盘自重时的空载、满载中心与四角位移，再在正常位移和公差余量之外设止挡，并确认小于允许过载位移。

除向下止挡，还值得补充抬起和横向碰撞保护；所有保护件在正常称重时保持不接触，避免旁路支撑。锁紧、装配可达性和运输保护一起考虑。

### 5. 热、线束与密封的寄生作用

玻璃、铝盘和胶的热变形差异、热杯传热、胶层蠕变都需在装配后测试。避免把硬胶或密封件跨接可动盘和固定壳体；传感器线留松弛弯并在固定侧应力释放。即使没有实体碰撞，线束牵拉仍可能影响回零。

底盖和 USB 接口密封保持在固定侧。当前主板三个真实 M2 孔和 4 mm 板下净空可作为布局基线，下一步按实际插头、THT 焊脚和线束弯曲半径校核，不需要为了加刚度盲目挪板。

## 验证顺序

1. 先处理承压基准、脚座螺纹和实物安装条件，再比较结构；否则仿真边界本身不明确。
2. 统一材料、玻璃、载荷和安装方式，比较中心及四角加载下的盘面位移、扭转和固定端底架变形。先可做固定加载端的结构相对比较；要预测整机，需加入传感器柔度和接触/预紧。
3. 原型测试分开记录几何位移与称重偏差。采用相同砝码、相同位置、统一标定，逐点回中心、卸载回零，并进行热杯和重复拆装试验。

刚度提高不等于偏载误差按相同比例下降，也不能仅凭 CAD 无干涉声明 ±0.2 g 已达成。
