puji4810/coffe-scale/pcb/s3.1/LOW_POWER_NEXT_REV.md

# 下一版 PCB：电源架构——真关机、待机功耗与可测量

2026-10-05：按用户要求，此次不改现有 s3.1 原理图、PCB、BOM 或 Gerber，也不做飞线。本文记录下一版的设计输入，不是已完成的可生产电路。

2026-10-10：范围扩展为整机电源架构：三种供电状态、总电源闩锁（真关机按钮）、待机漏电逐项清理、板载电流测量入口；TMP102 从 BOM 移除。本文仍是设计输入，未执行任何原理图/PCB/BOM 修改。

## 三种供电状态

| 状态 | 供电 | 退出方式 | 目标电池端电流 |
| --- | --- | --- | --- |
| 运行 | 全部轨 | — | 实测记录（背光/BLE 主导） |
| 待机 | 模拟轨切断，MCU deep sleep | 双击 INT1（IO13）/ MODE（IO18） | <100 µA |
| 关机 | VSYS 全断（两个 LDO 输入之前） | 仅电源键开机 | <5 µA（电池包保护板自耗除外） |

关机后双击唤醒、RTC、充电指示全失效——这是"真关机"的语义，与待机区分开。插 USB 应自动开机，保证充电和烧录不依赖按键。

## 当前限制

U7 HT7533 的输入直接接 VSYS。其输出 VDD_ADC 同时供 NAU7802 的 DVDD/AVDD/REFP、TMP102、J2/J11 的 E+。NAU7802 的 PUD/PUA 关闭只停止芯片内部工作，不切断电桥激励。

当前原理图注释采用 LC1330 输入电阻 410±10 Ω 的预算；若实装该型号，单桥在 3.3 V 下约 8 mA，双桥约 16 mA。实装电阻仍需确认。

J6 直挂 VSYS，没有任何电源开关：最深的低功耗态就是深睡，整板 ~10 mA 量级，"关机"只能靠拔电池。

TMP102（U3）即便实装，测的也是 PCB 上的空气温度，与电桥本体温度的对应关系很差，对温漂补偿没有价值——下一版从 BOM 移除。固件已容忍缺席（上电探测一次，读不到即关闭 thermal comp，不再轮询死地址）。若以后仍要温度数据，物理上正确的位置是电桥本体：J11/ch2 接 PT1000 贴传感器做比率测量（README 已预留此用法），而不是再放一颗板温计。

深睡下其余嫌疑漏电源（按估算量级排序）：

- 电桥激励：单桥 ~8 mA（410 Ω @3.3 V）——第一大头，靠模拟轨开关消灭。
- U6 XC6220B331 静态电流：高 PSRR LDO 的 Iq 在数十~百 µA 量级（随后缀与工作模式，需核对规格书），深睡下是第二大头。
- R13/R14 VBAT 分压 100k+100k 常挂电池：4.2 V 下 ~21 µA。
- N16R8 模组内 flash + 八线 PSRAM 的待机电流；深睡能否关 VDDSDIO 待验证。
- LCD 模块自身漏电：SLPIN 已发，但模块上背光 MOS/外围元件的静态电流不可控。
- TTP223 触摸模块（若 MODE 走触摸）：~4 µA，作为唤醒源保留供电。

## 必须落实的电路要求

### 总电源闩锁与关机

1. **切断点在 VSYS、两个 LDO 输入之前。** 关机 = 电桥/传感器/LCD/MCU 全断；EN 拉低这类"软关"不算——LDO 与外设仍然耗电。
2. **闩锁定稿：LTC2955**（2026-10-10 调查定稿）——按键开关控制器，覆盖全部需求：
   - VIN 1.5–36 V、Iq 1.2 µA，供在 VSYS 节点（任一电源在位即有电），关机预算内占 ~1.2 µA；
   - **ON 脚 = 电压监测自动开机**：接 VBUS 网即实现"插 USB/EXP_5V 自动开机"；**必须 RC 微分耦合只取上升沿**——ON 脚下降沿也能触发关机，直连的话电池供电下拔 USB 会误关机；
   - **INT → MCU**：按键通知，给收尾窗口；**KILL ← MCU**：确认断电。长按超 TMR 定时强制断——死机兜底；TMR 外接电容定时（C_TMR ≈ 0.19 µF/s，目标 ~2–3 s）；
   - **-2 后缀 EN 直接驱外部 P-MOSFET** 切 VSYS（-1 为高有效 EN，驱 LDO/负载开关场景）；PB 口 ±36 V、±25 kV ESD，可直接挂 J8 按键线；
   - 封装 TSOT-23-8（LTC2955ITS8-x）或 DFN-10；ADI/Linear 料 LCSC 有售，下单前核现货单价。
   备选淘汰记录：MAX16150（VCC 上限 5.5 V 贴 VBUS 5.25 V 裕量不足；关断定时固定 8/16 s；无电压监测自动开机）；双 MOSFET 软闩锁保留为兜底备选。
3. **按键复用**：MODE 兼电源键，接 IC 的 PB 脚，同时仍驱 IO18。关机态按下 = 开机；待机态短按 = 唤醒（维持现状）；运行态长按（~2–3 s）= 关机。**断电即全部清空**：不保留计时/去皮/模式等运行态，仅 NVS 校准存活（2026-10-10 改定）。
4. **VBUS 自动开机（边沿语义）**：USB（机器形态 EXP_5V 经 D3 反灌）接入时自动上电。TP4057 在闩锁上游，关机充电不受影响。注意 CHRG_STAT 上拉侧：关机充电时不能经 IO8 输入保护结构反灌整板。
5. **关机漏电预算**：LTC2955 自身 1.2 µA + 闩锁 PMOS 关断漏电 + INA226 shutdown + 按键路径 + 任何挂在 BAT+/VSYS 的常接负载，合计 <5 µA（电池包保护板自耗除外）。

### 机器形态（J10 / EXP_5V / D3）交互

- **EXP_5V 与 USB 等价**：D3 落地后 EXP_5V 灌在 VBUS 网上，经 D1/Q1 进 VSYS、经 TP4057 给电池充电，与插 USB 无法区分。自动开机触发点放在 VBUS 网，两个来源天然共用。
- **闩锁控制器供电取 VSYS 节点**（任一电源在位即有电）：机器形态无电池、无按键时靠 EXP_5V 供电并自动开机——机器上电 = 本板上电，正好替代缺失的按键。
- **自动开机为边沿语义**：电源从无到有触发一次；电源保持期间长按仍可关机并保持关（直到按键或电源重新接入）。不用电平保持式，否则插着线永远关不掉；机器侧想强制运行就循环 EXP_5V，本身就是硬重启。
- **D3 保持 B5819W 二极管 OR**：防 USB VBUS 反灌机器侧 5 V 母线，~0.3 V 压降下 TP4057 仍可充电；0R 直通等于双 5 V 源并联，仍不贴。
- **J10 pin20 EN 仍是复位**，不是开关机；机器侧重启本板用 EN 或循环 EXP_5V。
- **关机反灌窗口**：本板断电而机器侧带电时，UART 空闲高、I2C 上拉、XIO 高电平经 IO 保护二极管向 3V3 轨偷电——100R 串阻只限流（每脚最坏 ~26 mA）不阻断，可把 MCU 顶在半供电僵尸态。约束给机器侧：本板断电期间 J10 驱动必须高阻。固件侧缓解：检测到充电/外部供电在位时直接忽略长按关机。
- **远程关机通知（已定需要）**：机器侧经 J10.18/19 UART0 发关机请求（协议字节随机器协议定；XIO 专用线为备选）→ 固件收尾后拉 KILL **自切电源**——时序可控，比"预警后等掉电"干净；机器侧直接硬断 EXP_5V 也可接受：断电即清空、无非正常态，仅失去收尾机会。

### 模拟轨断电（沿用 2026-10-05 要求，TMP102 移除后修正）

6. **可控模拟供电。** 在 U7 输入前增加高侧负载开关，或换成合适的低静态电流带 EN 的 LDO。由 GPIO 控制，外部下拉保证复位和深睡默认关闭。额定输入要覆盖 USB 供电下的 VSYS；不要用只允许 3.3 V 输入的器件接这里。可评估 [TPS22919](https://www.ti.com/lit/ds/symlink/tps22919.pdf)（1.6～5.5 V，主动高 ON）；需要进一步核对封装、采购与整板压降预算。
7. **整轨切换。** AVDD、DVDD、REFP 与 J2/J11 E+ 一起受控，仍保持 NAU7802 外部 AVDD、内部 LDO 关闭。不要只切 E+ 而将 REFP 留在未切换轨上，否则开关压降不再由比率测量抵消。TMP102 已移除，受控侧外设只剩 NAU7802。
8. **I²C 断电隔离。** NAU7802 放在受控支路，LIS2DW12 留在常供电支路。SDA/SCL 必须采用经断电条件验证的隔离方案（PCA9306/TCA9509 类总线开关为候选），防止 3V3 侧上拉通过输入保护结构反向供电；受控侧上拉接 VDD_ADC。关断时共享总线仍应能与 LIS2DW12 通信。不能只加电源开关、保留原共享上拉连接。
9. **逐信号查反灌。** 核对 DRDY、ALERT、参考/输入以及外接 J11 设备是否存在其它电源来源。外设关断时 MCU 引脚必须为适当输入/高阻；禁止从 MCU 输出高电平给未供电器件。
10. **独立保留唤醒电源（待机态）。** LIS2DW12、MODE 按键/触摸模块、ESP RTC 待机时保持供电；关机态这些也断。**LCD 定稿独立负载开关 LCD_EN**（2026-10-10 定）：切 J7.2 模块 VCC，背光随灭；其 SCK/MOSI/CS/DC/BL 要检查反灌及默认电平，切前固件把各线置安全电平或高阻（见固件顺序）。

### 待机漏电逐项

11. **主 LDO 换低 Iq。** XC6220 换成 Iq <~30 µA、峰值 ≥500 mA（顶 BLE 发射峰值）的 LDO；候选方向 HT7833 / TLV755P / RT9013 一类，实贴前核对规格书、封装与采购。
12. **VBAT 分压。** 留在 BAT+（保留充电时读真实电池电压的能力），电阻改 1 MΩ+1 MΩ、中点并 100 nF 到地压低 ADC 源阻抗；~2 µA 计入关机漏电预算。**若 INA226 实装则此分压可省**（INA226 自带总线电压测量），DNP 板仍需要。要彻底清零可 PMOS 门控，复杂度换 2 µA，一般不划算。
13. **VDDSDIO 深睡断电（固件项）。** `esp_sleep_pd_config(ESP_PD_DOMAIN_VDDSDIO, OFF)`；N16R8 模组 flash/八线 PSRAM 的实际节省与可行性要验证，确认 RTC 保留数据不受影响。

### 可测量

14. **总电流入口**：BAT+ 与闩锁之间放常闭焊盘跳线 JP_IBAT（出厂连通）。剪开后可串万用表电流档，或焊 0.1–1 Ω 电阻量 mV；跳线两端留 2.54 mm 间距测试点方便挂表笔。量产板跳线保持连通。
15. **模拟支路入口**：ANALOG_SW 输出（或 U7 输入）侧同法放 JP_IADC，区分模拟轨与数字轨的消耗。
16. **电压测试点**（板边一排，丝印标名）：VBAT、VSYS_SW、3V3、VDD_ADC、ANALOG_EN、PWR_EN/PWR_HOLD、VBUS、CHRG_STAT、EN。
17. **INA226 电流计（定稿保留，2026-10-10 定）**：串在电池线高侧（JP_IBAT 位置），挂现有 I2C，`p` 命令读真实电流与总线电压。自身耗电（运行 Iq 数百 µA 级、shutdown µA 级，核规格书）计入待机/关机预算；待机进入 deep sleep 前固件置其 shutdown。注意它落在闩锁上游，关机态仍在位，靠 shutdown 控功耗。

### 引脚分配

18. ANALOG_EN 候选 IO2（NC、非 strapping），外部 100 kΩ 下拉保证上电默认关，更新 `board/pins.hpp`；IO14 在 J10 机器扩展用途不动。PWR_HOLD（或 IC 的 KILL/INT）与可选 LCD_EN 引脚随原理图定稿分配。

## 待机功耗预算（目标，不是承诺）

| 项 | 估算 |
| --- | --- |
| ESP32-S3 深睡（含 RTC） | ~10 µA |
| flash/八线 PSRAM 待机 | ~0（VDDSDIO 可断）– ~200 µA（不可断） |
| LIS2DW12 400 Hz 双击检测 | ~10–20 µA |
| 主 LDO Iq | ~2–25 µA（视选型） |
| VBAT 分压（1 MΩ/1 MΩ） | ~2 µA |
| 模拟轨关断漏电 | <1 µA |
| 闩锁 IC LTC2955 | ~1.2 µA |
| INA226（shutdown） | ~µA 级，实测 |
| TTP223（若实装） | ~4 µA |
| **合计** | **~30–250 µA**，目标 <100 µA |

对照：s3.1 深睡 ~10 mA、1000 mAh 电池约 4 天；100 µA 下理论待机超过一年。运行态功耗不受以上改动本质影响（LDO 是线性的，效率不变）。

## 对应固件顺序

待机：停止采样并等待在途 I²C 完成 → NAU7802 停止转换 → 切断受控轨/隔离 → 锁定 EN 默认关断 → （可选）VDDSDIO 断电 → RTC 待机。

唤醒：保持采样暂停 → 开启受控轨 → 等待电源建立 → 完整初始化 NAU7802（当前 init 包含 250 ms 模拟稳定、丢弃样本与 AFE 校准）和可选 ch2/PT1000 → 恢复用户校准/去皮 → 从新样本建立稳定性和流量证据。不要把第一次唤醒读数自动当成空盘零点。

新增：

- 关机流程（已定语义）：IC 的 INT（或机器侧 UART0 关机请求）→ 收尾：停止采样/I²C → LCD 各线置安全电平或高阻后切 LCD_EN → INA226 置 shutdown → 确认无 NVS 写进行中 → 拉 KILL 断电。超时未响应由 IC 长按定时强制断。**断电即全部清空，不写运行态快照**——仅 NVS 校准存活，冷启动全新状态。
- 检测到充电/外部供电在位时忽略长按关机请求（避免"带电关机"未定义态）；机器侧 UART0 关机请求仍执行（请求方意图明确）。
- MOSFET 闩锁备选（仅当 IC 退回）：复位后第一时间置位 PWR_HOLD，再做其它初始化。
- TMP102 缺席路径保持；若启用 ch2/PT1000，驱动与 thermal comp 输入路径要新写。

## 下一版验收

- 关断后 VDD_ADC 不应被 SDA/SCL/DRDY 等信号顶起；测量关断泄漏，不能只看 EN 逻辑值。
- 模拟轨关断时双击/MODE 唤醒可靠；两路称重传感器与外接 J11 负载都要覆盖。
- 比较开关前后的称重零点、跨度、噪声、温漂和唤醒稳定时间。
- 全部外设接齐、纯电池供电时经 JP_IBAT 测整板待机电流，与预算对账；超标用 JP_IADC 等支路跳线逐项排查。候选器件手册电流不等于整板结果。
- 关机态电池端总电流 <5 µA。
- 电源键全流程：关机按→开机、待机按→唤醒、运行长按→关机；固件死机（停喂狗/挂起）下长按仍能断电——IC 方案天然满足，MOSFET 闩锁需专门验证。
- 插 USB 自动开机且充电正常；关机充电行为按定义验证。
- 断电后冷启动为全新状态：无计时/去皮/模式残留，仅 NVS 校准生效。
- 机器侧 UART0 关机请求可正常断电；充电/外部供电在位时长按关机被忽略；硬断 EXP_5V 无非正常态。
- 称重性能回归与 s3.1 持平或说明差异。
- 完成原理图 ERC、PCB DRC、BOM/引脚核对与上板验证后再发布生产文件。此次未执行这些硬件修改或生产验证。

## 决策记录

已定（2026-10-10）：

- 闩锁：**LTC2955**——-2 型 EN 驱外部 P-MOSFET 切 VSYS；ON 脚 RC 微分接 VBUS/EXP_5V 边沿自动开机；INT/KILL 接 MCU 两 GPIO；TMR 电容设 ~2–3 s 长按关断；Iq 1.2 µA 计入关机预算。
- LCD：独立负载开关 LCD_EN，切 J7.2 模块 VCC。
- INA226：保留，串电池线高侧挂 I2C；实装后可省 R13/R14 分压；断电前置 shutdown。
- 断电语义：**全部清空**，不保留计时等运行态；仅 NVS 校准存活，无快照机制。
- 机器侧远程关机：需要通知——J10 UART0 发请求，固件拉 KILL 自切；硬断 EXP_5V 兜底等价。
- 自动开机语义：边沿触发（USB/EXP_5V 共用），带电可关机。

待定（原理图阶段常规工作，不再阻塞）：

- PMOS、TMR 电容、ON 脚 RC 微分等被动件取值。
- 机器协议里关机请求的字节定义。
