puji4810/coffe-scale/pcb/s3.1/RECHECK-2026-09-18-R2.md

# s3.1 再次校验（2026-09-18，第二轮）

**结论：上轮旧铺铜短路与制造包不同步问题已关闭，当前制造文件通过本轮复核，可用于小批工程样板。尚未达到满负载成品放行条件：D4 热预算须验证，现有固件须改为外部 AVDD 后才能用于称重测试。**

本报告更新上一份 `RECHECK-2026-09-18.md` 的版本结论；上一份对旧 ZIP 的禁止下单仍适用于其记录的旧哈希。本次未修改板文件、固件和制造文件，只新增报告与检查证据。

## 当前版本

| 对象 | SHA-256 |
|---|---|
| s3.1.kicad_pcb | `2668f66468aaad9ffd1be43f6109f606ff76cb8dccbe648324ae33c3b822667d` |
| s3.1-fabrication.zip | `f28d15212be0bed086334ab97e1a239624f262a11d7e77aaf330f6c981fefd19` |

检查结束前再次比对快照哈希，全部 92 个检查输入文件未发生变化。`s3.1.kicad_pcb.release` 与本轮板文件逐字节相同。

## 已复验通过

| 项目 | 结果 |
|---|---|
| ERC | 0 违规 |
| 已保存铜皮 DRC，不重填，含原理图一致性 | 0 错误、0 未连接、0 一致性问题 |
| 重填铺铜 DRC，含原理图一致性 | 同上 |
| 剩余警告 | 48 条 silk_overlap、2 条 silk_over_copper |
| 上轮短路位置的 GND 多边形检查 | D4.1、R22.2、SIG2_P 过孔中心均已退出 GND 铜皮 |
| 独立重导出与现有制造文件比对 | 9 层 Gerber + 钻孔全部一致，排除生成时间/校验注释 |
| ZIP 与 gerber 目录 | 11 个归档文件全部逐字节一致 |
| CPL 与 PCB | 73 个唯一位号，位置、值、封装匹配，双焊盘 R/C 轴向匹配 |
| CPL 与 BOM-jlc | 非 DNP 位号集合一致，无遗漏或额外位号 |
| R24–R31 | 生成脚本及 BOM 均已改为 C17408，0805 / 100Ω |
| D4 | 生成脚本及 BOM 均已指定 C64886，MDD B5819WS / SOD-323 |

因此，上一轮“已保存状态 24 错误、现有 ZIP 携带短路铜皮”的结论不再适用于本轮 ZIP。仅靠重填后 DRC 通过的问题已经通过“不重填检查 + 独立制造文件比对”关闭。

## D4：料号已关闭，热预算未关闭

[C64886 产品记录](https://www.lcsc.com/product-detail/C64886.html)与设计要求的 B5819WS / SOD-323 相符。该料号链接的 [MDD 原厂数据表 Rev2025A4](https://datasheet.lcsc.com/datasheet/pdf/eaf5c2f6bac84f09aa7fa91daf61fc91.pdf?productCode=C64886)列出：平均整流电流 1A，25°C 下耗散功率 250mW，结到环境热阻 400°C/W，最高工作结温 125°C；B5819WS 的 VF 最大值为 0.6V @ 1A。

必须同时满足电流与热限制。使用报告自己估算的 D4 损耗 **0.2W** 作条件计算：

- `ΔTj ≈ 0.2 × 400 = 80°C`。
- 环境 25°C 时，估算结温约 105°C；环境 40°C 时约 120°C，距离 125°C 上限仅 5°C。
- 按同一热阻和最高结温，环境 50°C 时功耗预算约为 `(125−50)/400 = 0.1875W`。

以上是数据表条件下的估算，不是实测板温；实际铜面积、气流、VF 和负载会影响结果。它说明“0.4–0.6A 小于 1A，所以有余量”不足以关闭热风险。

D4 电流包含充电与整机负载。工程样板可用于测量此风险，但不能据此放行高环境温度下持续满负载运行。验证应覆盖充电、Wi-Fi、显示、蜂鸣器并发，记录 USB 电流、D4 正向压降和稳态温升；若功耗/温升超出余量，需降低充电/系统电流或修改器件、布局。实测表面温度不能直接等同结温。机器功率板与显示负载也须纳入预算。

## 烧录前仍须修正

`firmware/components/nau7802/include/nau7802/nau7802.hpp:81` 仍无条件调用 `set_ldo()`；第 130 行仍将 `PU_CTRL.AVDDS` 置 1。默认值仍为 2.7V。

s3.1 已把 AVDD 接外部 VDD_ADC，驱动应保持 **AVDDS=0**，且不能被后续 `set_ldo()` 改回内部供电。此项不阻止裸板制造，但当前初始化不适合本板，烧录前必须处理。依据为 [NAU7802 Rev2.6，第 26 页的 AVDDS 定义](https://www.nuvoton.com/export/resource-files/en-us--DS_NAU7802_DataSheet_EN_Rev2.6.pdf)。

## 文件与首板注意项

- `BOM.csv` 仍有 17 行未正确转义逗号；当前 **BOM-jlc.csv 的 36 行均为正确 8 列**。贴片上传使用 BOM-jlc.csv；通用 BOM 生成器仍需改为规范 CSV 写入。
- BOM-jlc 中 D3、C23、C24 标为 DNP，CPL 已排除。贴片预览须保持这三项不贴，并核对有极性器件与 IC 的 pin 1 方向。
- README 的内部 2.7V AVDD、初始化后才出现 AVDD 等说明仍旧；按当前外部供电硬件执行上电检查。
- USB 信号质量、U6/U7 温升、低电压运行、模拟干扰及称重精度仍属首板实测。外部 3.3V 激励解决了桥路电流预算，但不等于 LC1330 在低于推荐激励下的精度已获验证。

证据位于 `recheck-2026-09-18-round2/`：输入哈希、保存状态与重填状态 DRC、ERC、制造文件与 CPL/BOM 对照 JSON。
