puji4810/coffe-scale/pcb/s3.1/RECHECK-2026-09-19-J8.md

# s3.1 J8 四针改版复核（2026-09-19）

**结论：J8 四针的电气连接及当前 ZIP 通过复核，可用于工程样板；“全部落地、原理图完全一致、旧三针线直接兼容”需要修正。** 当前还存在制造目录陈旧、PCB 生成脚本未同步、Description 一致性警告与不完整的 courtyard。未发现本次改动造成电源与地反接或保存铺铜短路。

本次仅新增报告和证据，未修改设计、固件和制造文件。此前 D4 温升与 NAU7802 外部 AVDD 固件适配仍未关闭，不能把工程样板放行等同整机满负载或量产验证通过。

## 文件与自动检查

| 文件 | SHA-256 |
|---|---|
| s3.1.kicad_pcb | `04f1a087369cb20fc8c9906e03c40caf8760cf436f558111ca70b310c766076b` |
| s3.1-fabrication.zip | `0acaa38f4847cdf162e03aae61b8102c78c77a4620c5a0b8a576adc21db6ceca` |

- ERC：0 违规。
- DRC（保存铜皮、不重填、带原理图一致性）：0 电气错误、0 未连接、47 条常规警告，另有 1 条原理图字段一致性警告。
- DRC（重填、带原理图一致性）：结果相同。
- 47 条常规警告为 45 条丝印相交和 2 条丝印压铜；额外一致性项是 J8 的 PCB Description 为空，而原理图填写了四针描述。没有引脚网络一致性错误。
- `s3.1.kicad_pcb.j8-4pin` 与当前 PCB 逐字节一致。
- CPL：73 个唯一贴片位号，坐标、值、封装及双焊盘 R/C 轴向匹配；与 BOM-jlc 非 DNP 位号集合相同。J8 为通孔手焊件，不在 73 点之内。

## J8 电气检查通过

独立从当前原理图导出网表，并读取 PCB 焊盘：

| 引脚 | 原理图及 PCB 网络 | PCB 坐标 mm |
|---|---|---|
| 1 | GND | (60, 10.2) |
| 2 | BTN_TARE | (62, 10.2) |
| 3 | BTN_MODE | (64, 10.2) |
| 4 | VCC_3V3 | (66, 10.2) |

新增电源已连接；MODE 支路没有未连接或间距错误。区域内存在 GND 缝合孔 (67, 7.4)，没有原 VCC 过孔 (68, 8)。检查采用当前存盘铜皮和重新填充两种方式，没有复现之前的旧铜皮短路问题。

## 需修正的文件与机械说明

### 1. ZIP 是新版，gerber 目录是旧版

从当前 PCB 独立导出后，ZIP 中双面铜、双面阻焊、双面锡膏、板框及钻孔与重新导出一致（排除生成时间/校验注释）。ZIP 的双面丝印与未裁减阻焊开窗的导出一致；此次 ZIP 没有预先执行 `--subtract-soldermask`，上传时需预览制造方的丝印裁剪。

但是，仓库 `gerber/` 全部 11 个文件仍与 9 月 18 日第二轮快照逐字节相同，是三针旧版。**只能使用本报告哈希对应的新 ZIP；不能从当前 gerber 目录重新打包。** 应同步更新目录，避免后续选错制造输入。

### 2. gen_pcb.py 仍生成三针

`tools/gen_pcb.py` 第 113 行 Description、第 204 行 J8 网络字典、第 347 行封装、第 751 行丝印都仍为三针，其中没有 J8.4 / VCC_3V3。重新执行该生成器会恢复三针定义；`gen_sch.py` 已更新为四针，二者不一致。应同步 PCB 生成源，并补齐实际 PCB 的 Description 字段。

板上独立丝印仍为 `J8 GND TARE MODE`，没有新增第 4 针电源标识；建议补成四针明确标识，特别是手焊接线版本。

### 3. courtyard 已缩入实体轮廓

J8 原点 x=60，F.Fab 实体右边界为局部 x=7.95，即全局 x=67.95；F.Courtyard 右边界仅局部 x=7.9，即 x=67.9。Courtyard 比实体边界还少 0.05mm，因此“不报外框重叠”不能用来证明装配空间充足。

[JST PH 原厂图纸](https://www.jst-mfg.com/product/pdf/eng/ePH.pdf)的四针直插座标称宽度为 9.9mm，与这里的实体外框一致。R15 本体左边界为 x=68.5，故与 J8 本体标称间隙约 0.55mm；R15 左焊盘边界 x=68.05，距 J8 塑壳标称边界只有 0.10mm。当前未发现标称实体碰撞，但公差、焊点和手焊空间余量有限。

建议恢复至少包住实体并保留装配余量的 courtyard，再按真实空间移动相邻元件或明确记录紧凑装配的风险接受。不能以继续缩小 courtyard 代替机械核对。

### 4. 三针“电气兼容”不等于旧插头直接兼容

前三针定义和孔位保留，旧机械按键功能可以继续用。但 JST PH 三位 PHR-3 与四位 PHR-4 是不同壳体，不能承诺原三位插头能在四位带护套座内正确定位、锁扣和防错插。[JST PH 图纸](https://www.jst-mfg.com/product/pdf/eng/ePH.pdf)

可靠做法是将旧三根线按原顺序装入四位 PHR-4 壳，空置第 4 位，或使用明确针序的转接线。README 中“老 3P 按键线仍兼容”应写明这一机械条件；不要依赖偏插旧壳体。

## TTP223 接线与设置

按 [Tontek TTP223-BA6 / TTP223N-BA6 原厂资料](https://www.tontek.com.tw/uploads/product/243/TTP223-BA6_V2.1_EN.pdf)，3.3V 处于工作电压范围，低有效点动需要 **AHLB=1、TOG=0**。AHLB 只控制有效电平，不负责取消自锁。不同模块的 A/B 焊盘命名不能直接代替芯片管脚定义。

- 两模块 GND → J8.1；模块 1 Q/OUT → J8.2；模块 2 Q/OUT → J8.3；两模块 VCC → J8.4。
- R15/R16 的 10k 上拉在输出低时每路约 0.33mA，负载较小。Q 是推挽输出；不要把两个模块 OUT 并联，也不要同时把机械按键接在同一信号线上强拉地。
- C18/C19 是输出线对地的 100nF 电容，可以保留做首板验证，但它们不再与 10k 上拉构成纯机械按键的同一种动态响应，需看实际模块带载后的边沿。
- 模块端须有靠近芯片的电源去耦。上电约 0.5 秒稳定期不要触摸；低功耗模式的响应可达约 220ms，固件体验需实测。
- 外接铜箔接感应电极 I 的节点，缩短电极到芯片的连线；电极面积、连线寄生电容和面板影响灵敏度，扩大面积后要重新验证误触与湿手情况。

## 延续的上电约束

当前 `nau7802.hpp:81` 仍调用 `set_ldo()`，第 130 行把 AVDDS 置 1；s3.1 的外部 AVDD 适配仍未完成。D4 仍为 C64886，按前轮报告验证充电与整机并发时温升。BOM-jlc 格式正确，普通 BOM.csv 的转义问题仍需修复。

原始检查证据保存在 `recheck-2026-09-19-j8/`，包含快照哈希、双模式 DRC、ERC、新网表和制造/CPL 比对结果。
