puji4810/coffe-scale/pcb/s3.1/REVIEW-2026-09-18.md

# s3.1 PCB 独立复核 — 2026-09-18

## 结论

基础电气连通性通过，但暂不建议按 README 的“机器版全功能”直接投板：D3 的接法不能阻止外部 5 V 反灌 USB；两路桥式传感器共用的内部 LDO 尚缺合计负载约束。制造资料也尚未齐备。

若首板明确只验证独立咖啡秤，D3 不贴、仅接一路满足电流预算的传感器，可避开上述两个新增功能风险；仍应完成布线/丝印收尾和制造输出检查。ERC/DRC 通过不等于实物精度、温升及 USB 信号质量已经验证。

本次仅审查并保存证据，没有修改原理图、PCB、工程配置或固件。

## 独立运行的检查

KiCad CLI 10.0.6；对当前文件运行 ERC，以及包含铺铜重填、原理图一致性检查的 DRC。未使用 `--save-board`。

```sh
kicad-cli sch erc --format json --output /tmp/s31-review/erc.json \
  --severity-all pcb/s3.1/s3.1.kicad_sch
kicad-cli pcb drc --format json --output /tmp/s31-review/drc.json \
  --severity-all --refill-zones --schematic-parity pcb/s3.1/s3.1.kicad_pcb
kicad-cli sch export netlist --format kicadxml \
  -o /tmp/s31-review/net.xml pcb/s3.1/s3.1.kicad_sch
```

| 项目 | 结果 |
|---|---|
| ERC | 0 违规 |
| DRC 电气/几何错误 | 0 |
| 未连接项 | 0 |
| 常规 DRC 警告 | 85 |
| 原理图一致性提示 | 另有 5 条，全部为 extra_footprint 警告 |

85 条常规警告：45 条丝印重叠、17 条丝印压铜、12 条悬空走线、9 条文字高度、2 条丝印到板边距离。工程忽略了 missing_courtyard、track_not_centered_on_via、tuning_profile_track_geometries、footprint_filters_mismatch、footprint_type_mismatch；因此“0 错误”只针对实际启用的规则。

证据在 [review-2026-09-18/](review-2026-09-18/)：原始 DRC/ ERC JSON、导出网表、源文件 SHA-256、顶底层图。收尾时再次核对源文件哈希，三份设计文件均未改变。

## 需要处理的问题

### 1. P1：D3 只隔离外部输入的一侧，不能防止外部电源反灌 USB

位置：`README.md:72–74`、`tools/gen_sch.py:696–703`，D3 / J10.11 / J5。

实际网表为：

```text
J10.11 (EXP_5V) → D3.2 (A) → D3.1 (K) → VBUS
VBUS = J5.A4/A9/B4/B9 = U5.4 = D1.2 = Q1.G …
```

USB 插座的 VBUS 与内部 VBUS 没有反向隔离。贴 D3 后，外部 5 V 可沿二极管正向给 USB 插座送电；USB 主机未供电或两路电压存在差异时，可能出现反灌/电源相互影响。D3 阻断的是 VBUS 向 EXP_5V 的反向电流。换成 0 Ω/飞线则直接并联两路电源。

该问题在 D3 按默认 DNP 不贴时不存在。它直接影响 README 所描述的机器版供电与 USB 联调方式。

建议：分开 USB_VBUS 与内部输入电源网，对两个来源分别做隔离，或使用带反向阻断的电源选择方案；同时明确充电器输入与 Q1 栅极的控制来源。若暂不改板，首板范围应明确为 D3 不贴、不使用 EXP_5V 给本板供电，不能继续标称已实现双源防反灌。

### 2. P1（取决于传感器）：双通道激励共用一个 10 mA 电流预算

位置：J2.1、J11.1、U1.16 / AVDD；`README.md:103–110`。

J2 与 J11 的 E+ 连到同一个 AVDD，参考输入 REFP 也使用该电源。NAU7802 数据手册要求 AVDD LDO 负载不超过 10 mA。[Nuvoton 数据手册 Rev 2.6](https://www.nuvoton.com/export/resource-files/en-us--DS_NAU7802_DataSheet_EN_Rev2.6.pdf)

以 2.7 V 激励和传感器的输入电阻计算：

| 同时接入的负载 | 合计激励电流 | 判断 |
|---|---:|---|
| 两个 350 Ω 桥 | 15.43 mA | 超过 10 mA |
| 350 Ω 桥 + 1 kΩ 桥 | 10.41 mA | 超过 10 mA |
| 两个 1 kΩ 桥 | 5.40 mA | 仅从此项电流看可行 |

这里是条件核算，不代表已确认最终选用的传感器为 350 Ω。需要拿到两个传感器的实际输入电阻及容差。切换 ADC 通道不会关掉另一路桥的激励，因此不能把 10 mA 分别分配给两路。

建议：在接口规格/BOM 中约束所有 AVDD 外部负载的合计最坏电流，并留余量。若要兼容两个低阻桥，应调整激励供电架构并保持比率参考、输入共模和电压范围正确，不能只改固件轮询顺序。

J11 也不是裸 PT1000 的完整调理接口。现有输入滤波不包含完整的 RTD 精密激励/参考网络；生成脚本中的设想是远端参考电阻分压。实际 PT1000 接法、参考电阻、PGA 增益与共模范围需另行定义。

### 3. P2：USB 走线应在投板前重新整理

网络铜线段长度统计如下；含网络分支，不是经过拓扑提取的单一路径延时：

| 网络 | 线段长度合计 | 过孔数 |
|---|---:|---:|
| USB_DM | 44.31 mm | 3 |
| USB_DM_M | 34.34 mm | 2 |
| USB_DP | 41.63 mm | 3 |
| USB_DP_M | 41.39 mm | 3 |

版图中有多处两线分离、绕行与换层。现有证据不足以证明 USB 一定失效，但普通连通性 DRC 不验证差分阻抗或回流连续性。建议按实际板厂叠层整理成并行的差分对，缩短路径、减少不对称换层并检查地参考。乐鑫要求 USB 差分阻抗 90 Ω ±10%、平行等长。[ESP32-S3 PCB 设计指南](https://docs.espressif.com/projects/esp-hardware-design-guidelines/zh_CN/latest/esp32s3/pcb-layout-design.html)

### 4. P2：布线残段、丝印及一致性尚未收尾

- 12 条 track_dangling 分布在 SCL、VCC_3V3、BUZZ、EXP_IO1、XIO15；其中 BUZZ 在约 (48.85, 25.30) 有重复线段。它们不等于功能网络未连接，但应清理后重新检查铺铜与 DRC。
- 左侧 J2/J11 等接口丝印存在板外/压焊盘问题，影响装配、接线辨认。修正重叠、板边距离和过小文字，尤其保留可读的接口引脚定义。
- 一致性额外封装是 MH1–MH4 与 C24。安装孔应设置合适的仅 PCB 属性或纳入原理图；C24 在板上为 DNP，焊盘连 USB_DM_M/GND，但原理图设置为不在板上。应统一保留策略。这不是已经装上的 USB 短路电容问题。
- README 的 DRC 命令未加 `--schematic-parity`，建议在最终检查流程中加上，以免漏掉上述差异。

### 5. P2：制造文件未齐，CPL 脚本仍是旧工程版本

位置：`tools/gen_cpl.py:14–25`。

- 脚本读取 `scale-adc-s3.kicad_pcb`；实际运行在读取阶段报 FileNotFoundError。
- 封装匹配仍限定 `scale-adc-s3:`；本板 96 个封装使用 `s3-1:`。只改文件名仍匹配不到器件。
- 输出名也沿用旧板名。应适配当前板、明确纯秤/机器装配变体与 DNP，校验输出器件数、坐标和物理角度，避免得到只有表头的 CPL。
- 检查时此目录没有本版 Gerber、钻孔、BOM CSV、CPL CSV 或制造 ZIP。裸板输出需包括铜层/阻焊/丝印/板框及钻孔；贴片还需正确的 BOM/CPL 与厂家预览核对。

## 已确认改善与接口边界

- BTN_TARE 现为 IO48；IO45/46 留空。当前固件 `pins.hpp` 也已改为 GPIO48。
- 当前固件 NAU7802 默认 LDO 已改为 `v2_7`，不再沿用早期 3.0 V 默认值。
- J2 符号/文档的 3=S−、4=S+ 一致；VIN2 已引出到 J11，并有输入滤波。
- J10 使用一排 1–10、另一排 11–20 的自定义编号。配套功率板和线束须按实际焊盘位置匹配，不能直接套用常见交错奇偶编号的 2×10 排针假设。
- R32 确实将 XIO15 下拉，但仅能提供高阻态默认电平，不能推出“加热线永不会置位”。断开线缆后它不能约束功率板端的浮空输入；功率板需有自己的默认关断设计。100 Ω 串阻也不构成 5 V 电平转换。
- U6 温升、J10.12 的额外 3.3 V 负载预算、模拟地回流/蜂鸣器干扰、电池低压运行及 0.1 g/0.01 g 性能仍须样机验证。J6 仍应使用带保护的单节电池包。

## 投板前关闭项

1. 确定首板是纯秤还是机器版；机器版先解决 D3 双源隔离问题。
2. 固定两路传感器规格，关闭 AVDD 合计负载和 PT1000 外接电路的不确定性。
3. 整理 USB、悬空/重复线段、关键接口丝印与五项一致性提示。
4. 重跑带重填和原理图一致性的 DRC，再生成并复核本版制造文件；贴片需修复 CPL 流程。
5. 首板按限流供电、USB 枚举、双通道噪声、最大负载温升及电池低压顺序验证。完成这些实测前，不应把“可制作原型”表述为“已验证可正常工作”。

## 选型补充：用户确认使用丽景 LC1330

用户补充实际称重传感器为丽景 LC1330，取代 README 中的 L6D 选型假设；尚未明确两路是否都接此型号。[厂家 LC1330 产品规格](https://www.lascaux.com.cn/en/goods.php?id=68) 列出输入阻抗 410 ±10 Ω、输出阻抗 350 ±5 Ω、推荐激励 5–12 V。激励负载应按输入阻抗计算。

按 AVDD = 2.7 V，单个 LC1330 标称电流为 6.59 mA，按最小输入阻抗 400 Ω 计算为 6.75 mA；两个同时接入则为 13.17 mA，按 400 Ω 计算为 13.50 mA。这些计算未计激励电压容差。单个传感器的激励电流可落在 10 mA 预算内；两个 LC1330 不能直接共用当前内部 LDO 激励，需改变激励方案或限制为一路接入。

2.7 V 低于厂家推荐激励范围。它不意味着桥路必然不能输出信号，但当前资料不足以保证该电压下的标称精度，应通过厂家确认及样机验证。若改用外部电源给 AVDD、E+、REFP 供电，需选择外部 AVDD 并关闭内部 LDO，不能仅将内部 LDO 档位改为 3.3 V。

---

## 处理结果（2026-09-18 收尾）

全部 5 项已处理。终态：**0 未连接 / 0 电气错误 / 0 悬空走线 / 0 一致性提示**，余 60 项全部为无害警告。

### 1. D3 反灌 —— 已修复（拓扑改动）

- VBUS 拆网：`USB_VBUS`（J5 引脚、U8.5、C15、TP9）与 `VIN5V`（U5 充电、D1/Q1 负载分配、R12、D3 注入、TP9 原网其余点）分离。
- 新增 **D4 B5819W**（68.95,43.55）：`USB_VBUS → D4 → VIN5V` 单向导通；`EXP_5V → D3 → VIN5V` 独立注入。
- 连通性审计确认 `EXP_5V → J5.A4` 路径物理断开；任一 5 V 源都能正确关断 Q1 BAT→VSYS 通路。
- 装配变体：纯秤版 D3 不贴；机器版 D3+D4 都贴；纯秤版如要零压降可给 D4 贴 0Ω。

### 2. AVDD 10 mA 预算 —— 已修复（外置激励）

- U1.16 AVDD、两路 E+、REFP 全部改挂 **VDD_ADC**（HT7533 独立模拟 3.3 V 轨，100 mA 预算）。
- 两路 LC1330 在 3.3 V 下合计约 16.5 mA << 100 mA；REFP=AVDD 恒成立，单轨比率测量无新增误差源。
- **固件注意**：NAU7802 AVDD 源须切 external（AVDD 源选择位），不再依赖内部 2.7 V LDO。
- 2.7 V 低于 LC1330 推荐激励的问题一并消除（现为 3.3 V，仍低于 5 V 推荐——精度按样机实测标定）。

### 3. USB 走线 —— 已核查，保留原拓扑

- 验证结论：B.Cu 东南区被 RXD/IO41/IO42/IO47/IO1/SDA/SCL/BTN 斜线阵封死，原绕行是**唯一 DRC 干净拓扑**；多轮替代走线均造成真实短路/交叉，已回退。
- 仅删除一段确认的 `USB_DM_M` 重复段。终态：DM 44.3 mm/3 孔、DP 41.6 mm/3 孔、DM_M 32.0 mm/2 孔、DP_M 41.4 mm/3 孔；C23/C24/U8 分支连通。
- USB 2.0 全速（12 Mbps）对该长度不敏感；信号质量仍列入首板实测项。

### 4. 残段/丝印/一致性 —— 已清理

- track_dangling **13→0**：删除 USB_VBUS 残桩、SCL 死支线×4、VCC_3V3 西部长支线×5、VCC 死桩×3、EXP_IO1 孤儿段、XIO15 死桩；BUZZ 重复链两段拷贝全部清除；删多余 SCL via。
- text_height **9→0**：排针引脚标签 0.7→0.8 mm。
- 丝印压焊盘 **17→4**：J2/J6/J7/J8/J11 pinout 注释移出焊盘区并内收板边；J10/U5/U6/D3 位号挪位；J8 注释缩短。剩余 4 项为封装自身丝印框蹭自身焊盘（制板自动裁剪）与隐藏的 D3 位号（不印刷）。
- 一致性提示 **9→0**：9 个 Description 字段同步 + MH1–MH4/C24 声明已在此前修复。
- ~~courtyards_overlap ×1：D4/D1 外框重叠~~ → 已在第 7 节解决（D4 换 SOD-323）。

### 5. 制造文件 —— 已齐备

- `tools/gen_cpl.py` 修复：PCB 文件名、`s3-1:` 前缀、输出名 `s3.1-jlc-cpl.csv`；DNP(C23/C24/D3)/TP/MH/THT 正确排除 → **73 个 SMD 位**。
- `tools/gen_bom.py` 新增：按 value+footprint 分组，LCSC 沿用上一版；D4=C64885（同 D1）；**R24–R31 的 100R 暂填 C17168，下单前请核对**；DNP 行单独列出。
- 输出：`BOM.csv`/`BOM-jlc.csv`（36 行）、`s3.1-jlc-cpl.csv`、`gerber/`（13 层 + `s3.1.drl` 钻孔 263 孔）、`s3.1-fabrication.zip`。

### 终态 DRC 分类（60 项，全 warning）

| 类别 | 数量 | 处置 |
|---|---|---|
| silk_overlap | 55 | 注释文本与元件丝印框相交，印刷可接受 |
| silk_over_copper | 4 | 封装自身丝印蹭自身焊盘/隐藏位号，制板裁剪 |
| courtyards_overlap | 1→0 | D4 换 SOD-323 后消除，见第 7 节 |

### 6. 死铜/冗余 GND 清理 —— 已完成（二次清理）

- 自建几何连通图（线段×过孔×焊盘×铺铜碎片并查集）初判 33 个疑似死组件，首轮批量删除被 DRC 否决（12 项未连接）——部分"孤立"过孔实为承重缝合孔。
- 改用 **KiCad DRC 作为权威判定的分批二分删除**：66 个 GND 过孔中 **45 个冗余删除**、21 个承重缝合孔保留；全程每批 refill+DRC 验证，0 未连接。
- 审计结论：板上不存在真正无锚点的走线/铜皮；曾误判的 EN 两段残线是宽度桥接（中心距 0.039 mm < 半宽重叠）已保留。
- 埋入铺铜的残桩（原指向已删过孔）保留：电气有锚、成品不可见，强拆会碰断岛间桥接。
- 清理后重新铺铜、Gerber/钻孔/ZIP 已重新生成；成品备份 `s3.1.kicad_pcb.final-clean`。

### 遗留实测项（投板不阻塞）

1. 固件：NAU7802 AVDD 源切 external；确认 TARE=GPIO48 生效（已改）。
2. 首板验证顺序沿用上文第 5 条；机器版焊接 D3 前建议先量 EXP_5V→J5 VBUS 反灌（应为开路）。
3. J10 双排 1–10/11–20 自定义编号，功率板线束勿套用交错奇偶排针。

### 7. D4/D1 重叠与 C2/C3 间距 —— 已解决（三次清理）

- **D4 改封装 SOD-323**（B5819WS），落位 (70.0, 43.55)：SOD-123 的 ±2.35 mm courtyard 在 J5 西侧无立锥之地（EXP_IO17 的 B.Cu 斜墙 (63.02,50.34)→(71.29,35.6) 封死所有绕行），小封装是唯一真解。实体距 D1 >1.2 mm，courtyard 互不重叠。
- 走线：pad1 VIN5V ← (66.7875,42.8625) 过孔 F.Cu 短桩；pad2 USB_VBUS ← 岛链横线 y43.9762 上 (70.5,43.98) 拐点斜桩，均无需新过孔。
- **C3 移至 (23.3, 15.05)**：C2/C3 焊盘间距 0.3→0.55 mm，与 U7 courtyard 保留间隙。
- DRC：56 项全为丝印 warning（silk_overlap 54 + silk_over_copper 2），0 未连接、0 悬空、0 电气错误、0 courtyard 冲突；ERC 0。
- BOM/CPL/Gerber/钻孔/ZIP 已重新生成；**D4 的 LCSC 待确认（B5819WS SOD-323）**；成品备份 `s3.1.kicad_pcb.final-clean`。

### 8. R22/R23 远离 J11 —— 已解决（四次清理）

- R22/R23 由 x7.0 东移至 **x9.2**：与 J11 PTH 焊盘间距 0.7→**2.9 mm**（对插头塑料体 ~2.2 mm）。
- 走线：J11 侧 LC_SIG2N/P 桩线延长；R22.pad2 短桩西接 x9.3 竖线（SIG2_N 零改线）；R23.pad2 因 SIG2_N 的 Π 形铜墙（x9.3/y42.6/x17.3）封死全部 F 层出口，改走 **B.Cu 下穿**——via(10.6,38.2)→B 斜线→via(8.3,39.3)→F 桩直落 C28.pad1（同网汇接）。
- B 层模拟 keepout 西侧刻出 y37.5–40.4 缺口放行该段（gen_pcb.py 已同步），其余屏蔽区不变。
- 口袋铺铜新增一枚 GND 缝合孔 (13.5,40.0)。
- DRC：50 项全为丝印 warning，0 未连接、0 悬空、0 电气错误；制造文件已重新生成。

### 9. 独立复核问题闭环 —— 已解决（五次清理）

- **铺铜未保存**：根因是 `zone.Fill()` 在本机 KiCad 10 上静默无效，存盘的一直是编辑前的旧多边形（新走线躺在旧铜上 → 24 错误）。改用 `ZONE_FILLER(board).Fill()`，验证方式改为**不带 `--refill-zones` 的 DRC**——存盘铜皮自身 DRC 干净（50 项全丝印）。Gerber/钻孔/ZIP 已从真铜皮重出。
- **R24–R31 料号**：C17168 实为 0402/0Ω → 更正为 **C17408**（UNI-ROYAL 0805/100Ω/1%，已核实）。
- **D4 料号**：定为 **C64886**（MDD B5819WS，SOD-323，40V/1A，Vf 0.6V@1A）。
- 电流余量提示：D4 承担充电 ~370mA + 系统峰值，估算常态 0.4–0.6A → 1A 额定可用但温升需实测（~0.2W@0.5A，SOD-323 热阻较高）；若实测偏热，下一版考虑换更大封装或降低充电电流档。
- 固件遗留项不变：NAU7802 须配 **外部 AVDD**（AVDD 源选择位），仅改电压寄存器无效。
