puji4810/coffe-scale/mechanical/optimization/v032_reference/references/support-reference.png

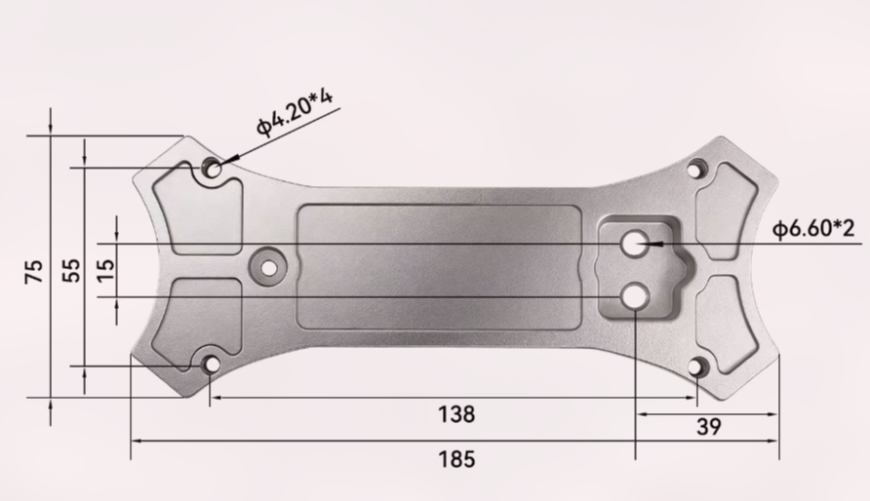
mechanical/optimization/v032_reference/references/support-reference.png
