puji4810/coffe-scale/mechanical/references/lc1330-dimensions.jpg

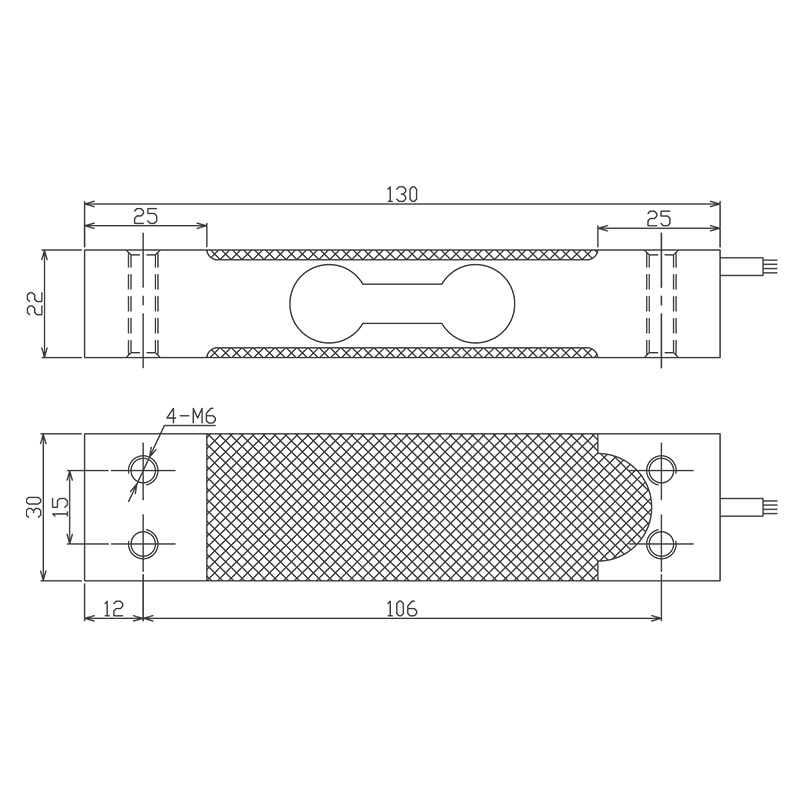
mechanical/references/lc1330-dimensions.jpg
