puji4810/coffe-scale/pcb/s3.1/review-2026-09-18/top.png

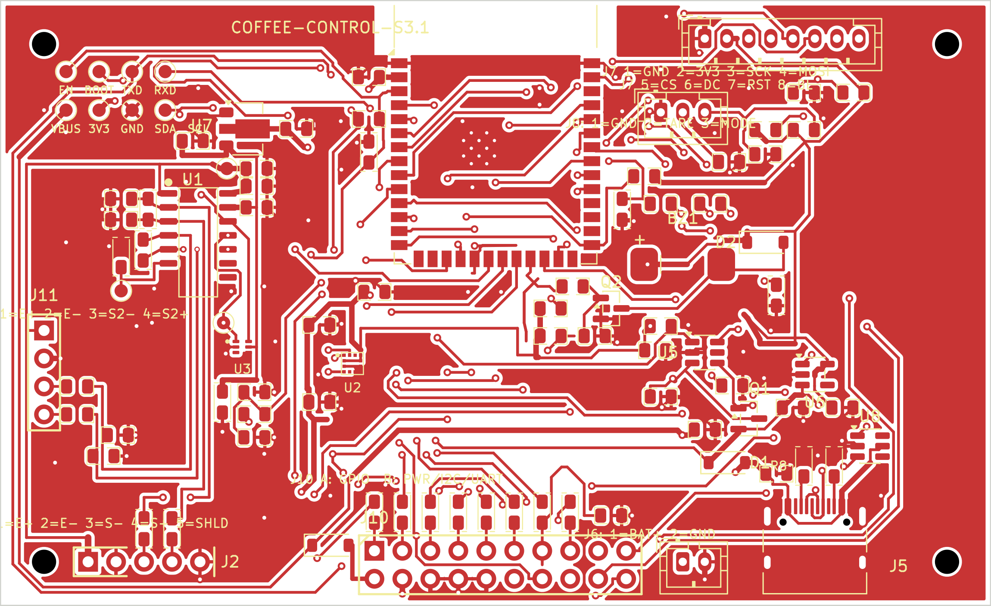
pcb/s3.1/review-2026-09-18/top.png
