puji4810/coffe-scale/firmware/tests/fixtures/brew-20261003-weight.csv

t_s | weight_g
0.0 | 5.09
0.1 | 5.29
0.2 | 5.58
0.3 | 5.74
0.4 | 6.05
0.5 | 6.16
0.6 | 6.52
0.7 | 7.00
0.8 | 7.62
0.9 | 7.86
1.0 | 8.31
1.1 | 8.70
1.2 | 9.25
1.3 | 9.53
1.4 | 9.70
1.5 | 10.01
1.6 | 10.26
1.7 | 10.71
1.8 | 11.22
1.9 | 12.35
2.0 | 12.93
2.1 | 13.44
2.2 | 13.88
2.3 | 14.16
2.4 | 14.78
2.5 | 14.99
2.6 | 15.26
2.7 | 15.99
2.8 | 16.53
2.9 | 17.15
3.0 | 17.40
3.1 | 18.24
3.2 | 18.69
3.3 | 19.58
3.5 | 20.96
3.6 | 21.04
3.7 | 21.28
3.8 | 21.70
3.9 | 22.12
4.0 | 22.34
4.1 | 22.76
4.2 | 24.12
4.3 | 24.29
4.4 | 24.99
4.5 | 25.37
4.6 | 25.80
4.7 | 26.46
4.8 | 26.87
4.9 | 27.22
5.0 | 27.77
5.1 | 27.73
5.2 | 28.04
5.4 | 29.46
5.5 | 29.45
5.6 | 29.60
5.7 | 30.06
5.8 | 30.55
5.9 | 30.50
6.1 | 31.18
6.2 | 31.46
6.3 | 31.93
6.4 | 33.00
6.5 | 33.09
6.6 | 33.12
6.7 | 33.09
6.8 | 33.05
6.9 | 33.05
7.0 | 33.14
7.1 | 33.17
7.2 | 33.01
7.3 | 33.32
7.4 | 33.08
7.5 | 33.13
7.6 | 33.20
7.7 | 33.27
7.8 | 33.13
7.9 | 33.05
8.0 | 33.25
8.1 | 33.10
8.2 | 32.81
8.3 | 33.25
8.4 | 33.41
8.5 | 33.36
8.6 | 33.26
8.7 | 33.19
8.8 | 33.07
8.9 | 33.22
9.0 | 33.04
9.1 | 40.46
9.2 | 25.25
9.3 | 33.93
9.4 | 34.30
9.5 | 31.80
9.6 | 30.74
9.7 | 30.76
9.8 | 32.78
10.0 | 33.41
10.1 | 33.35
10.2 | 33.28
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
