puji4810/coffe-scale/firmware/tests/fixtures/brew-20261015-weight.csv

t_s | grams
0 | 5.57
0.1 | 5.82
0.2 | 6.12
0.3 | 6.68
0.4 | 7.01
0.5 | 7.64
0.6 | 8.15
0.7 | 8.66
0.9 | 8.94
1 | 9.22
1.1 | 9.46
1.2 | 9.98
1.3 | 10.6
1.4 | 11.26
1.5 | 11.52
1.6 | 11.79
1.7 | 12.16
1.8 | 12.42
1.9 | 12.73
2 | 13.14
2.1 | 13.83
2.2 | 14.35
2.3 | 15.23
2.4 | 15.73
2.5 | 16.22
2.6 | 16.42
2.7 | 17.2
2.9 | 17.71
3 | 18.94
3.1 | 19.81
3.2 | 20.52
3.3 | 20.63
3.4 | 21.36
3.5 | 21.25
3.6 | 22.13
3.7 | 22.46
3.8 | 23.3
4 | 23.8
4.1 | 24.35
4.2 | 25.11
4.3 | 25.48
4.4 | 25.54
4.5 | 25.85
4.6 | 26.11
4.7 | 27.07
4.8 | 27.54
4.9 | 27.86
5 | 28.29
5.1 | 28.5
5.2 | 28.88
5.3 | 29.5
5.4 | 30.2
5.6 | 30.59
5.7 | 31.21
5.8 | 31.02
5.9 | 31.13
6 | 31.38
6.1 | 31.5
6.3 | 31.44
6.4 | 31.34
6.5 | 31.19
6.7 | 31.4
6.8 | 31.34
6.9 | 31.31
7 | 31.32
7.1 | 31.29
7.2 | 31.21
7.3 | 31.2
7.4 | 31.43
7.5 | 31.37
7.7 | 31.38
7.8 | 31.38
7.9 | 31.31
8 | 31.24
8.1 | 31.13
8.2 | 31.14
8.3 | 31.25
8.4 | 31.27
8.5 | 31.21
8.6 | 31.21
8.7 | 31.29
8.8 | 31.28
8.9 | 31.36
9 | 31.36
9.1 | 31.33
9.2 | 31.24
9.3 | 31.24
9.4 | 31.24
9.5 | 31.29
9.6 | 31.29
9.7 | 31.29
9.8 | 31.3
9.9 | 31.29
10 | 31.28
10.1 | 31.3
10.2 | 31.21
10.3 | 31.3
10.4 | 31.29
10.5 | 31.27
10.6 | 31.26
10.7 | 31.29
10.8 | 31.29
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
