puji4810/coffe-scale/firmware/tests/fixtures/brew-20261017-weight.csv

t_s | grams
0 | 6.78
0.1 | 7.26
0.2 | 7.6
0.3 | 8.4
0.4 | 8.98
0.5 | 9.89
0.6 | 10.35
0.7 | 10.78
0.8 | 11.08
1 | 11.68
1.1 | 12.01
1.2 | 12.86
1.3 | 13.36
1.4 | 14.19
1.5 | 14.75
1.6 | 15.06
1.7 | 15.45
1.8 | 15.87
1.9 | 16.11
2.1 | 16.83
2.3 | 17.95
2.4 | 18.49
2.5 | 18.91
2.6 | 19.44
2.7 | 20.31
2.8 | 20.86
2.9 | 20.67
3 | 21.19
3.1 | 21
3.2 | 20.88
3.3 | 21.46
3.4 | 22.26
3.5 | 22.6
3.6 | 20.28
3.7 | 20.32
3.8 | 22.59
3.9 | 24.06
4 | 24.95
4.1 | 25.47
4.2 | 28.06
4.3 | 27.16
4.4 | 26.95
4.6 | 26.93
4.7 | 27.61
4.8 | 27.73
4.9 | 28.08
5 | 28.49
5.1 | 28.7
5.3 | 28.98
5.4 | 29.45
5.5 | 30.42
5.6 | 30.71
5.7 | 31.51
5.8 | 31.55
5.9 | 31.63
6 | 31.9
6.1 | 32.16
6.3 | 33.24
6.4 | 33.55
6.6 | 33.98
6.7 | 34.27
6.8 | 34.48
6.9 | 34.56
7 | 34.58
7.1 | 34.47
7.2 | 34.45
7.3 | 34.54
7.4 | 34.6
7.5 | 34.42
7.6 | 34.35
7.7 | 34.38
7.8 | 35.45
7.9 | 35.38
8 | 35.4
8.1 | 34.51
8.2 | 34.76
8.3 | 34.67
8.4 | 34.42
8.5 | 33.69
8.7 | 34.08
8.8 | 33.98
8.9 | 34.06
9 | 34.56
9.1 | 34.84
9.2 | 34.38
9.3 | 34.55
9.4 | 34.57
9.5 | 34.47
9.6 | 34.34
9.7 | 34.36
9.8 | 34.39
9.9 | 34.4
10 | 34.38
10.1 | 34.37
10.2 | 34.29
10.3 | 34.36
10.4 | 34.37
10.5 | 34.46
10.6 | 34.43
10.7 | 34.44
10.8 | 34.4
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
