puji4810/coffe-scale/firmware/tests/fixtures/brew-continuous-weight.csv

t_s | weight_g
0.00 | 0.19
0.10 | 0.17
0.20 | 0.18
0.30 | 0.19
0.40 | 0.18
0.50 | 0.16
0.60 | 0.16
0.70 | 0.16
0.80 | 0.16
0.90 | 0.16
1.00 | 0.16
1.10 | 0.17
1.20 | 0.15
1.30 | 0.17
1.40 | 0.15
1.50 | 0.14
1.60 | 0.35
1.70 | 0.59
1.80 | 0.98
1.90 | 1.43
2.00 | 2.19
2.10 | 2.68
2.30 | 3.72
2.40 | 3.98
2.50 | 4.57
2.60 | 5.10
2.70 | 5.67
2.90 | 6.34
3.00 | 6.72
3.10 | 7.09
3.20 | 7.73
3.30 | 8.17
3.40 | 8.68
3.50 | 9.04
3.60 | 9.51
3.70 | 10.16
3.80 | 11.10
3.90 | 11.66
4.00 | 12.04
4.10 | 12.50
4.30 | 13.15
4.40 | 13.57
4.50 | 14.18
4.60 | 14.63
4.70 | 15.20
4.80 | 15.30
4.90 | 15.86
5.00 | 16.44
5.10 | 17.50
5.30 | 18.19
5.40 | 18.85
5.50 | 19.22
5.60 | 19.53
5.70 | 19.69
5.80 | 20.01
6.00 | 20.48
6.10 | 20.92
6.20 | 21.41
6.30 | 22.10
6.40 | 22.55
6.50 | 22.95
6.60 | 23.11
6.70 | 23.58
6.80 | 23.74
6.90 | 24.14
7.00 | 24.49
7.10 | 24.89
7.30 | 25.57
7.40 | 26.01
7.50 | 26.61
7.60 | 26.91
7.70 | 27.34
7.80 | 27.61
7.90 | 27.86
8.10 | 28.25
8.20 | 28.64
8.30 | 29.04
8.40 | 29.25
8.50 | 29.60
8.60 | 30.01
8.70 | 30.68
8.80 | 30.98
8.90 | 31.53
9.00 | 31.60
9.20 | 31.85
9.30 | 32.00
9.40 | 32.25
9.50 | 32.54
9.60 | 32.79
9.70 | 33.07
9.80 | 33.27
9.90 | 33.53
10.00 | 33.66
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
