puji4810/coffe-scale/firmware/web/testdata/label.png

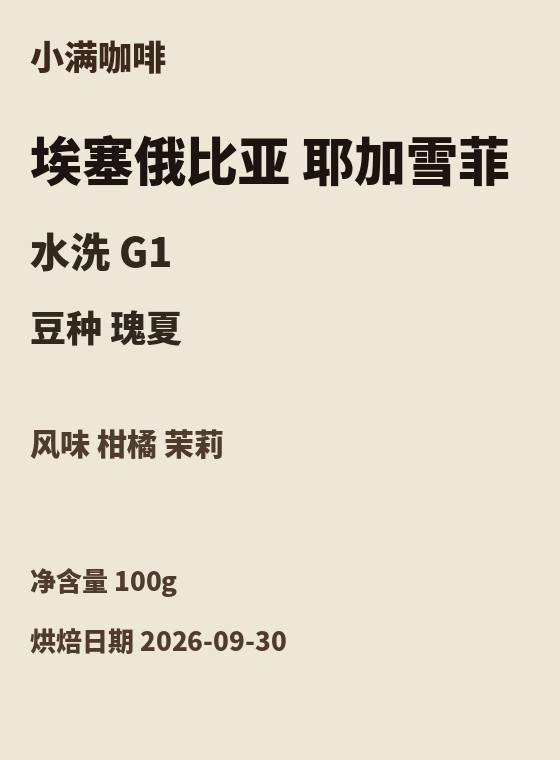
firmware/web/testdata/label.png
