puji4810/coffe-scale/pcb/s3.1/testpoint-map.png

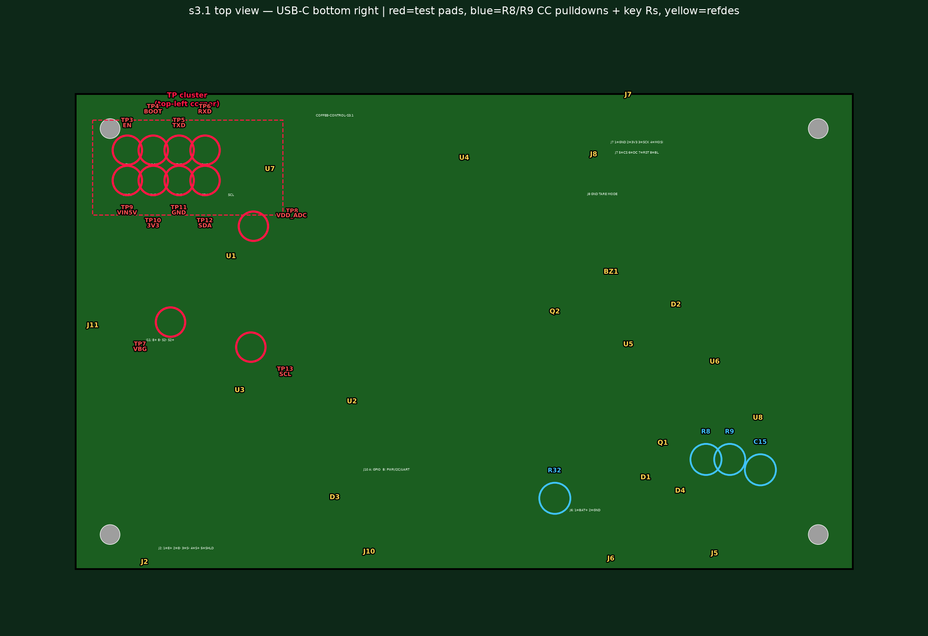
pcb/s3.1/testpoint-map.png
