puji4810/coffe-scale/(list of files, drawings)

Other design files:
mechanical/optimization/references/pcb-snapshot.json
mechanical/optimization/v032_reference/references/pcb-snapshot.json
mechanical/references/pcb-snapshot.json
mechanical/v044/references/pcb-snapshot.json
