puji4810/coffe-scale/pcb/s3.1/s3.1.kicad_pcb

## KiCad design pcb/s3.1/s3.1.kicad_pcb (2026-09-30)

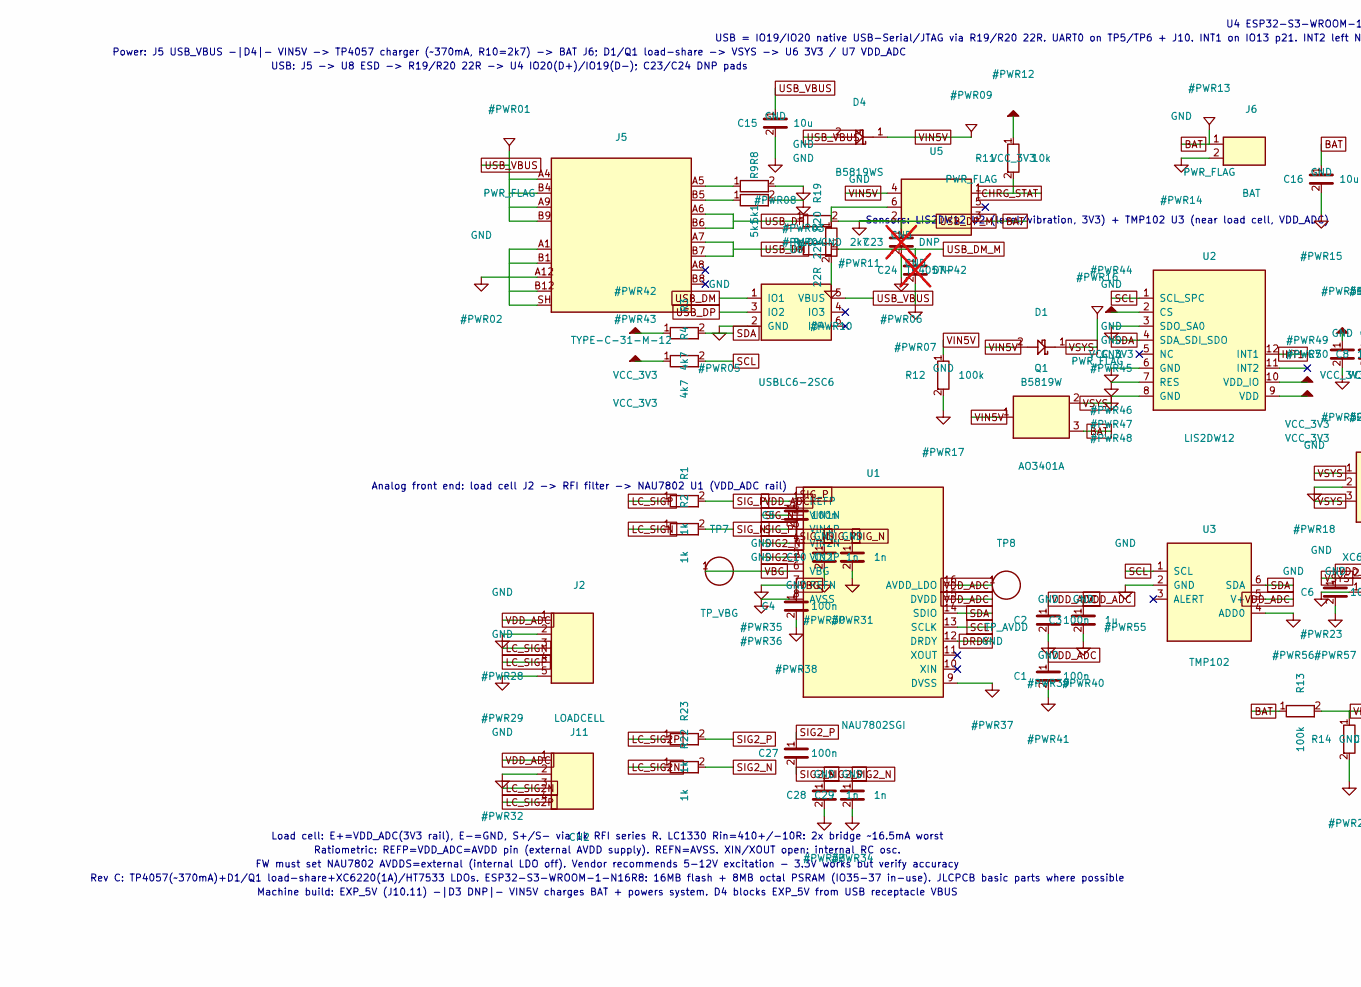
[picture p7: schematic s3.1.kicad_sch, CoffeeScale Control Board s3.1 (ESP32-S3), part in row 1, column 1]

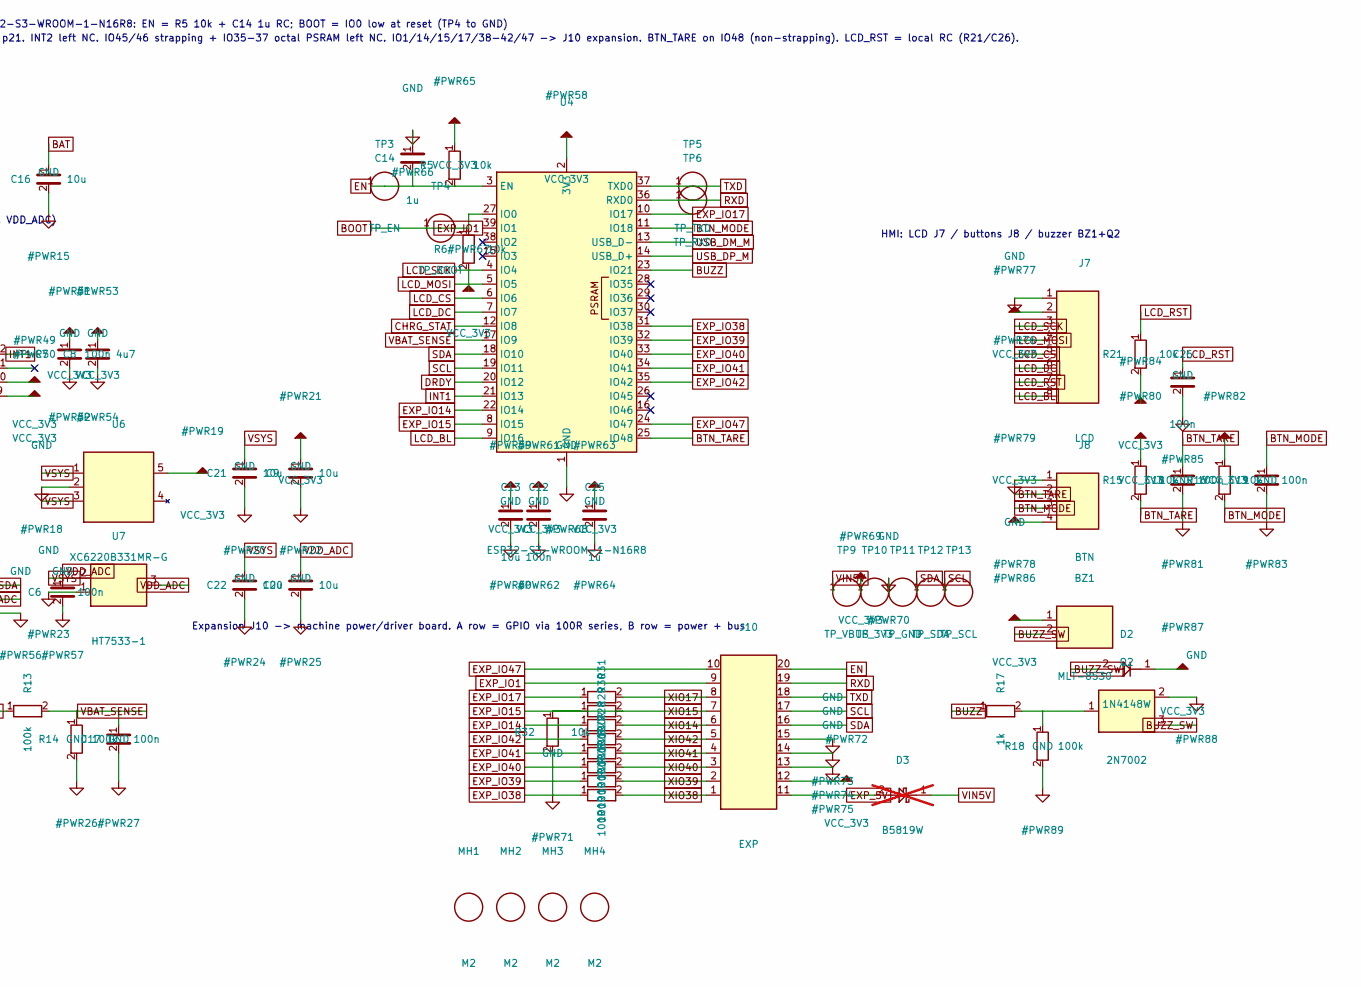
[picture p8: schematic s3.1.kicad_sch, CoffeeScale Control Board s3.1 (ESP32-S3), part in row 1, column 2]

Parts:
BZ1: MLT-8530; MagneticBuzzer_CUI_CMT-8540S-SMT
C1, C2, C7, C17, C18, C19, C26: 100n; SMD_0805
C3, C25: 1u; SMD_0805
C4, C5, C27: 100n; SMD_0805_VR
C6: 100n; SMD_0805_V
C8: 4u7; SMD_0805
C9, C13, C15, C16, C20, C21, C22: 10u; SMD_0805
C10, C11: 1n; SMD_0805_F
C12: 100n; SMD_0805_F
C14: 1u; SMD_0805_V
C23, C24: DNP; SMD_0805_V; not fitted
C28, C29: 1n; SMD_0805
D1: B5819W; D_SOD-123
D2: 1N4148W; D_SOD-123
D3: B5819W; D_SOD-123; not fitted
D4: B5819WS; D_SOD-323
J2: LOADCELL; PinHeader_1x05_P2.54mm_H
J5: TYPE-C-31-M-12; USB_C_Receptacle_HRO_TYPE-C-31-M-12
J6: BAT; JST_PH_B2B-PH-K_1x02_P2.00mm_Vertical
J7: LCD; JST_PH_B8B-PH-K_1x08_P2.00mm_Vertical
J8: BTN; JST_PH_B4B-PH-K_1x04_P2.00mm_Vertical
J10: EXP; PinHeader_2x10_P2.54mm_Vertical
J11: CH2; PinHeader_1x04_P2.54mm
MH1, MH2, MH3, MH4: M2; MountingHole_M2_NPTH
Q1: AO3401A; SOT-23
Q2: 2N7002; SOT-23
R1, R2: 1k; SMD_0805_VR
R3, R4: 4k7; SMD_0805
R5, R6, R11, R15, R16, R21, R32: 10k; SMD_0805
R8, R9: 5k1; SMD_0805_VR
R10: 2k7; SMD_0805
R12, R13, R14, R18: 100k; SMD_0805
R17, R22, R23: 1k; SMD_0805
R19, R20: 22R; SMD_0805_F
R24, R25, R26, R27, R28, R29, R30, R31: 100R; SMD_0805_V
TP3: TP_EN; TestPoint_1.2mm
TP4: TP_BOOT; TestPoint_1.2mm
TP5: TP_TXD; TestPoint_1.2mm
TP6: TP_RXD; TestPoint_1.2mm
TP7: TP_VBG; TestPoint_1.2mm
TP8: TP_AVDD; TestPoint_1.2mm
TP9: TP_VBUS; TestPoint_1.2mm
TP10: TP_3V3; TestPoint_1.2mm
TP11: TP_GND; TestPoint_1.2mm
TP12: TP_SDA; TestPoint_1.2mm
TP13: TP_SCL; TestPoint_1.2mm
U1: NAU7802SGI; SOIC-16_3.9x9.9mm_P1.27mm
U2: LIS2DW12; LGA-12_2x2mm_P0.5mm_LIS2DW12
U3: TMP102; SOT-563_1.6x1.6mm_P0.5mm
U4: ESP32-S3-WROOM-1-N16R8; ESP32-S3-WROOM-1
U5: TP4057-42; SOT-23-6
U6: XC6220B331MR-G; SOT-23-5
U7: HT7533-1; SOT-89-3
U8: USBLC6-2SC6; SOT-23-6

Connections:
BOOT: R6.1, TP4.1, U4.27 (IO0)
BTN_MODE: C19.1, J8.3 (BTN_MODE), R16.2, U4.11 (IO18)
BTN_TARE: C18.1, J8.2 (BTN_TARE), R15.2, U4.25 (IO48)
BUZZ: R17.1, U4.23 (IO21)
BUZZ_SW: BZ1.2 (-), D2.2 (A), Q2.3 (D)
CHRG_STAT: R11.2, U4.12 (IO8), U5.1 (CHRG)
DRDY: U1.12 (DRDY), U4.20 (IO12)
EN: C14.2, J10.20 (EN), R5.2, TP3.1, U4.3 (EN)
EXP_5V: D3.2 (A), J10.11 (5V)
EXP_IO1: J10.9 (IO1), U4.39 (IO1)
EXP_IO14: R29.1, U4.22 (IO14)
EXP_IO15: R30.1, U4.8 (IO15)
EXP_IO17: R31.1, U4.10 (IO17)
EXP_IO39: R25.1, U4.32 (IO39)
EXP_IO40: R26.1, U4.33 (IO40)
EXP_IO41: R27.1, U4.34 (IO41)
EXP_IO42: R28.1, U4.35 (IO42)
EXP_IO47: J10.10 (IO47), U4.24 (IO47)
INT1: U2.12 (INT1), U4.21 (IO13)
LCD_BL: J7.8 (LCD_BL), U4.9 (IO16)
LCD_CS: J7.5 (LCD_CS), U4.6 (IO6)
LCD_DC: J7.6 (LCD_DC), U4.7 (IO7)
LCD_MOSI: J7.4 (LCD_MOSI), U4.5 (IO5)
LCD_RST: C26.1, J7.7 (LCD_RST), R21.1
LCD_SCK: J7.3 (LCD_SCK), U4.4 (IO4)
LC_SIG2N: J11.3 (S2-), R22.1
LC_SIG2P: J11.4 (S2+), R23.1
LC_SIGN: J2.3 (S-), R2.1
LC_SIGP: J2.4 (S+), R1.1
unnamed: J5.A5 (CC1), R8.1
unnamed: J5.B5 (CC2), R9.1
unnamed: Q2.1 (G), R17.2, R18.1
unnamed: R10.1, U5.6 (PROG)
RXD: J10.19 (RXD), TP6.1, U4.36 (RXD0)
SCL: J10.17 (SCL), R4.2, TP13.1, U1.13 (SCLK), U2.1 (SCL_SPC), U3.1 (SCL), U4.19 (IO11)
SDA: J10.16 (SDA), R3.2, TP12.1, U1.14 (SDIO), U2.4 (SDA_SDI_SDO), U3.6 (SDA), U4.18 (IO10)
SIG2_N: C27.2, C29.1, R22.2, U1.4 (VIN2N)
SIG2_P: C27.1, C28.1, R23.2, U1.5 (VIN2P)
SIG_N: C5.2, C11.1, R2.2, U1.2 (VIN1N)
SIG_P: C5.1, C10.1, R1.2, U1.3 (VIN1P)
TXD: J10.18 (TXD), TP5.1, U4.37 (TXD0)
USB_DM: J5.A7 (DN1), J5.B7 (DN2), R20.1, U8.1 (IO1)
USB_DM_M: C24.1, R20.2, U4.13 (USB_D-)
USB_DP: J5.A6 (DP1), J5.B6 (DP2), R19.1, U8.3 (IO2)
VBAT_SENSE: C17.1, R13.2, R14.1, U4.17 (IO9)
VBG: C4.1, TP7.1, U1.6 (VBG)
VCC_3V3: BZ1.1 (+), C7.1, C8.1, C9.1, C12.1, C13.1, C25.1, D2.1 (K), J7.2 (VCC_3V3), J8.4 (VCC_3V3), J10.12 (3V3), R3.1, R4.1, R5.1, R6.2, R11.1, R15.1, R16.1, R21.2, TP10.1, U2.2 (CS), U2.9 (VDD), U2.10 (VDD_IO), U4.2 (3V3), U6.5 (VOUT)
VDD_ADC: C1.1, C2.1, C3.1, C6.1, C20.1, J2.1 (E+), J11.1 (E+), TP8.1, U1.1 (REFP), U1.15 (DVDD), U1.16 (AVDD_LDO), U3.5 (V+), U7.3 (VOUT)
XIO14: J10.6 (IO14), R29.2
XIO15: J10.7 (IO15), R30.2, R32.1
XIO17: J10.8 (IO17), R31.2
XIO38: J10.1 (IO38), R24.2
XIO39: J10.2 (IO39), R25.2
XIO40: J10.3 (IO40), R26.2
XIO41: J10.4 (IO41), R27.2
XIO42: J10.5 (IO42), R28.2

Notes on the sheet:
Power: J5 USB_VBUS -|D4|- VIN5V -> TP4057 charger (~370mA, R10=2k7) -> BAT J6; D1/Q1 load-share -> VSYS -> U6 3V3 / U7 VDD_ADC
Analog front end: load cell J2 -> RFI filter -> NAU7802 U1 (VDD_ADC rail)
Sensors: LIS2DW12 U2 (level/vibration, 3V3) + TMP102 U3 (near load cell, VDD_ADC)
HMI: LCD J7 / buttons J8 / buzzer BZ1+Q2
USB: J5 -> U8 ESD -> R19/R20 22R -> U4 IO20(D+)/IO19(D-); C23/C24 DNP pads
Load cell: E+=VDD_ADC(3V3 rail), E-=GND, S+/S- via 1k RFI series R. LC1330 Rin=410+/-10R: 2x bridge ~16.5mA worst
Ratiometric: REFP=VDD_ADC=AVDD pin (external AVDD supply). REFN=AVSS. XIN/XOUT open: internal RC osc.
FW must set NAU7802 AVDDS=external (internal LDO off). Vendor recommends 5-12V excitation - 3.3V works but verify accuracy
Rev C: TP4057(~370mA)+D1/Q1 load-share+XC6220(1A)/HT7533 LDOs. ESP32-S3-WROOM-1-N16R8: 16MB flash + 8MB octal PSRAM (IO35-37 in-use). JLCPCB basic parts where possible
Machine build: EXP_5V (J10.11) -|D3 DNP|- VIN5V charges BAT + powers system. D4 blocks EXP_5V from USB receptacle VBUS
U4 ESP32-S3-WROOM-1-N16R8: EN = R5 10k + C14 1u RC; BOOT = IO0 low at reset (TP4 to GND)
USB = IO19/IO20 native USB-Serial/JTAG via R19/R20 22R. UART0 on TP5/TP6 + J10. INT1 on IO13 p21. INT2 left NC. IO45/46 strapping + IO35-37 octal PSRAM left NC. IO1/14/15/17/38-42/47 -> J10 expansion. BTN_TARE on IO48 (non-strapping). LCD_RST = local RC (R21/C26).
Expansion J10 -> machine power/driver board. A row = GPIO via 100R series, B row = power + bus

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
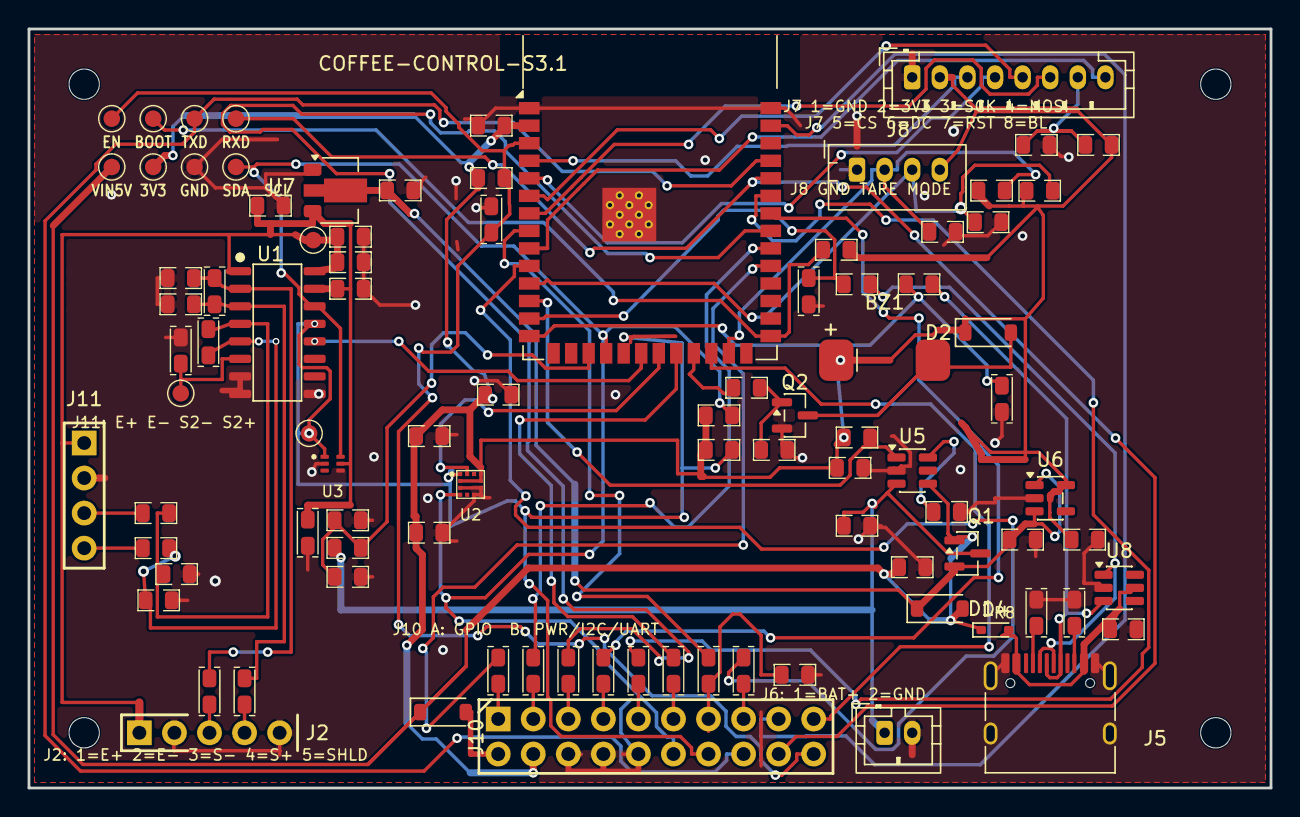
[picture p9: board s3.1.kicad_pcb from above]

Board: 2 copper layers, 90.0 x 55.0 mm, 97 parts (0 on the bottom side), 63 nets.
