puji4810/coffe-scale/firmware/components/scale_core/include/scale/app.hpp

#pragma once

/// Application model: scale pipeline + brew timer + display mode + unit.
/// Platform code feeds samples and button events; the UI renders `snapshot()`.
/// Pure C++, fully host-testable.

#include <cstdint>

#include "scale/brew_timer.hpp"
#include "scale/scale.hpp"
#include "scale/units.hpp"

namespace scale {

class app {
public:
    enum class mode { weigh, brew };

    struct snapshot {
        float             grams;
        float             flow_gps;   // pour rate, g/s (0 until window fills)
        bool              stable;     // load-cell quiet AND no IMU motion
        bool              tared;
        bool              calibrated;
        unit              u;
        mode              m;
        brew_timer::state timer_state;
        clock_ms          timer_elapsed;
        float             pitch_deg;  // trusted only while the unit is still
        float             roll_deg;
    };

    /// Small value-only RTC payload; filters and their old time axis are
    /// re-earned from live samples after a deep-sleep reboot.
    struct standby_state {
        calibration cal;
        float tare_counts;
        float zero_offset_g;
        unit u;
        mode m;
        bool timer_paused;
        clock_ms timer_elapsed;
    };

    /// One ADC conversion. `now` is the same injected time base used by the
    /// timer APIs (e.g. esp_timer_get_time()/1000 on target, steady_clock in
    /// tests/sim). Also feeds the flow/zero-track time axis — keep it real.
    void feed(std::int32_t counts, clock_ms now) {
        if (sleeping_) return;
        scale_.push(counts, now);
        now_ = now;
    }

    /// One accelerometer sample in mg (LIS2DW12, ~10-25 Hz).
    void feed_accel(float x_mg, float y_mg, float z_mg) {
        scale_.feed_accel(x_mg, y_mg, z_mg);
    }

    /// TARE (short press): zero in any mode.
    void tare() { scale_.tare(); }

    /// TARE (long press): in brew mode toggles the timer; elsewhere ignored.
    void tare_long() {
        if (!sleeping_ && mode_ == mode::brew) {
            timer_.toggle(now_);
        }
    }

    /// Hardware commands use their arrival time, even before the first
    /// ADC conversion after wake. Sim/replay may use the injected feed time.
    void tare_long(clock_ms now) {
        if (sleeping_) return;
        now_ = now;
        tare_long();
    }

    /// Freeze at the sleep request, before peripherals are torn down.
    /// Idle stays idle; a running timer pauses and retains its elapsed time.
    void prepare_sleep(clock_ms now) {
        if (sleeping_) return;
        now_ = now;
        timer_.pause(now);
        sleeping_ = true;
    }

    /// Resume the model clock before enabling controls or BLE. The timer
    /// stays idle/paused until the user explicitly starts/resumes it.
    void wake(clock_ms now) {
        now_ = now;
        sleeping_ = false;
    }

    [[nodiscard]] bool sleeping() const { return sleeping_; }

    [[nodiscard]] standby_state save_standby() const {
        return {scale_.calibration_data(), scale_.tare_counts(),
                scale_.zero_offset_g(), unit_, mode_,
                timer_.current() != brew_timer::state::idle,
                timer_.elapsed(now_)};
    }

    /// Called on a fresh app before sampling/controls begin. Calibration,
    /// tare, mode and paused brew survive; a removed tared cup stays negative.
    void restore_standby(const standby_state& saved, clock_ms now) {
        scale_.load_calibration(saved.cal);
        scale_.restore_offsets(saved.tare_counts, saved.zero_offset_g);
        unit_ = saved.u;
        mode_ = saved.m;
        scale_.set_zero_tracking(mode_ == mode::weigh);
        timer_.restore_paused(saved.timer_elapsed, saved.timer_paused);
        wake(now);
    }

    /// Reset the brew timer to 0:0.0 in any mode (does not touch tare).
    void timer_reset() { timer_.reset(); }

    /// MODE (short press): weigh <-> brew.
    void next_mode() {
        mode_ = mode_ == mode::weigh ? mode::brew : mode::weigh;
        if (mode_ == mode::weigh) {
            timer_.reset();
        }
        // Freeze slow drift for the brew session — dripping/evaporation
        // remains real mass. Proven physical unloads may still restore zero.
        scale_.set_zero_tracking(mode_ == mode::weigh);
    }

    void               set_unit(unit u) { unit_ = u; }
    [[nodiscard]] unit current_unit() const { return unit_; }
    [[nodiscard]] mode current_mode() const { return mode_; }

    // Calibration passthroughs (UI/menu layer decides when to call).
    void cal_zero() { scale_.cal_zero(); }
    bool cal_span(float mass_g) { return scale_.cal_span(mass_g); }
    void load_calibration(const calibration& c) { scale_.load_calibration(c); }

    /// Feed the ambient/sensor temperature (TMP102) — drives drift comp.
    void set_temperature(float temp_c) { scale_.set_temperature(temp_c); }

    [[nodiscard]] scale&       inner() { return scale_; }
    [[nodiscard]] const scale& inner() const { return scale_; }

    /// Weight for the readout: display-quantised grams (hysteresis) in
    /// the current unit. snapshot().grams stays continuous.
    [[nodiscard]] float display_value() const {
        return convert(scale_.display_grams(), unit_);
    }

    [[nodiscard]] snapshot state() const {
        return {.grams         = scale_.grams(),
                .flow_gps      = scale_.flow_gps(),
                .stable        = scale_.system_stable(),
                .tared         = scale_.tared(),
                .calibrated    = scale_.calibrated(),
                .u             = unit_,
                .m             = mode_,
                .timer_state   = timer_.current(),
                .timer_elapsed = timer_.elapsed(now_),
                .pitch_deg     = scale_.pitch_deg(),
                .roll_deg      = scale_.roll_deg()};
    }

private:
    scale      scale_;
    brew_timer timer_;
    unit       unit_ = unit::gram;
    mode       mode_ = mode::weigh;
    clock_ms   now_{0};
    bool       sleeping_ = false;
};

} // namespace scale
