puji4810/coffe-scale/pcb/s3.1/tools/fix_routes8.py

#!/usr/bin/env python3
# fix_routes8: rip-up the B.Cu IO-farm fences + south fanout stubs that make
# VSYS/MOSI/IO39/EN/SCL unroutable, then add only the verified manual links.
import re

PCB = "s3.1.kicad_pcb"
txt = open(PCB).read()

DEL_SEGS = [
    # ---- my bad round-7 adds (EN y23.15/x20.1 pieces collide with DRDY via) ----
    ("EN", "B.Cu", 26.15, 44.38, 26.15, 23.15),
    ("EN", "B.Cu", 26.15, 23.15, 20.1, 23.15),
    ("EN", "B.Cu", 20.1, 23.15, 20.1, 8.81),
    ("EN", "B.Cu", 20.1, 8.81, 32.45, 8.81),
    ("EN", "B.Cu", 26.15, 23.15, 25.0, 23.15),
    ("EN", "F.Cu", 34.8951, 13.3549, 34.9, 14.3),
    ("EN", "F.Cu", 34.9, 14.3, 34.4, 14.6),
    # ---- SCL bad via stubs (via at 28.75,30.9 shorts VCC) ----
    ("SCL", "F.Cu", 28.8777, 30.0095, 28.75, 30.9),
    ("SCL", "B.Cu", 28.75, 30.9, 28.8777, 30.9),
    # ---- RXD B.Cu fence (x55.64 vert) + J10.19 fanout ----
    ("RXD", "B.Cu", 55.6357, 20.2096, 55.6357, 15.5),
    ("RXD", "B.Cu", 60.7092, 25.2831, 55.6357, 20.2096),
    ("RXD", "B.Cu", 60.7092, 33.319, 60.7092, 25.2831),
    ("RXD", "B.Cu", 58.1596, 35.8686, 60.7092, 33.319),
    ("RXD", "B.Cu", 58.1596, 50.5222, 58.1596, 35.8686),
    ("RXD", "B.Cu", 57.3685, 51.3133, 58.1596, 50.5222),
    ("RXD", "B.Cu", 56.3133, 51.3133, 57.3685, 51.3133),
    ("RXD", "B.Cu", 55.5467, 52.0799, 56.3133, 51.3133),
    ("RXD", "B.Cu", 55.5467, 52.54, 55.5467, 52.0799),
    ("RXD", "B.Cu", 54.32, 52.54, 55.5467, 52.54),
    # ---- EXP_IO38 B.Cu ----
    ("EXP_IO38", "B.Cu", 52.6506, 22.6276, 51.163, 21.14),
    ("EXP_IO38", "B.Cu", 53.1672, 41.6845, 53.7822, 41.0695),
    ("EXP_IO38", "B.Cu", 53.3367, 22.6276, 52.6506, 22.6276),
    ("EXP_IO38", "B.Cu", 53.7822, 23.0731, 53.3367, 22.6276),
    ("EXP_IO38", "B.Cu", 51.163, 21.14, 51.163, 17.3362),
    ("EXP_IO38", "B.Cu", 53.7822, 41.0695, 53.7822, 23.0731),
    # ---- EXP_IO40 B.Cu ----
    ("EXP_IO40", "B.Cu", 42.7552, 46.0449, 45.3836, 43.4165),
    ("EXP_IO40", "B.Cu", 50.3788, 18.3785, 50.3788, 16.6897),
    ("EXP_IO40", "B.Cu", 45.3836, 23.3737, 50.3788, 18.3785),
    ("EXP_IO40", "B.Cu", 40.5354, 46.0449, 42.7552, 46.0449),
    ("EXP_IO40", "B.Cu", 45.3836, 43.4165, 45.3836, 23.3737),
    ("EXP_IO40", "B.Cu", 50.3788, 16.6897, 52.4385, 14.63),
    # ---- EXP_IO41 B.Cu ----
    ("EXP_IO41", "B.Cu", 44.7465, 19.3443, 44.7465, 25.3776),
    ("EXP_IO41", "B.Cu", 47.6338, 15.8688, 47.9279, 16.1629),
    ("EXP_IO41", "B.Cu", 33.8542, 23.04, 41.0254, 15.8688),
    ("EXP_IO41", "B.Cu", 44.7465, 25.3776, 42.7558, 27.3683),
    ("EXP_IO41", "B.Cu", 42.7558, 27.3683, 42.7558, 44.4158),
    ("EXP_IO41", "B.Cu", 47.9279, 16.1629, 44.7465, 19.3443),
    ("EXP_IO41", "B.Cu", 33.8542, 23.6615, 34.2474, 24.0547),
    ("EXP_IO41", "B.Cu", 42.7558, 44.4158, 42.5323, 44.6393),
    ("EXP_IO41", "B.Cu", 33.8542, 23.6615, 33.8542, 23.04),
    ("EXP_IO41", "B.Cu", 41.0254, 15.8688, 47.6338, 15.8688),
    # ---- EXP_IO42 B.Cu ----
    ("EXP_IO42", "B.Cu", 41.7444, 25.3611, 40.8126, 26.2929),
    ("EXP_IO42", "B.Cu", 40.8126, 31.5949, 41.5177, 32.3),
    ("EXP_IO42", "B.Cu", 41.7444, 19.8023, 41.7444, 25.3611),
    ("EXP_IO42", "B.Cu", 47.8633, 45.1493, 49.2373, 43.7753),
    ("EXP_IO42", "B.Cu", 49.2373, 43.7753, 49.2373, 34.0328),
    ("EXP_IO42", "B.Cu", 50.0865, 14.479, 50.0865, 15.5698),
    ("EXP_IO42", "B.Cu", 40.8126, 26.2929, 40.8126, 31.5949),
    ("EXP_IO42", "B.Cu", 45.0012, 16.5455, 41.7444, 19.8023),
    ("EXP_IO42", "B.Cu", 52.3168, 12.2487, 50.0865, 14.479),
    ("EXP_IO42", "B.Cu", 40.8126, 27.0919, 40.8126, 31.5949),
    ("EXP_IO42", "B.Cu", 40.8126, 26.2929, 40.8126, 27.0919),
    ("EXP_IO42", "B.Cu", 40.8126, 27.0919, 40.8126, 26.2929),
    # ---- EXP_IO14 B.Cu ----
    ("EXP_IO14", "B.Cu", 46.4971, 25.2317, 46.4971, 44.1191),
    ("EXP_IO14", "B.Cu", 46.4971, 44.1191, 46.7024, 44.3244),
    ("EXP_IO14", "B.Cu", 46.9062, 24.8226, 46.4971, 25.2317),
    # ---- EXP_IO1 B.Cu fence ----
    ("EXP_IO1", "B.Cu", 51.2579, 32.1902, 51.2579, 45.7112),
    ("EXP_IO1", "B.Cu", 54.32, 50.0, 54.32, 48.7733),
    ("EXP_IO1", "B.Cu", 51.2579, 45.7112, 54.32, 48.7733),
    # ---- XIO15 F.Cu (blocks the y51.3 lane; reroute via y47.0) ----
    ("XIO15", "F.Cu", 53.05, 51.27, 53.05, 46.8),
    ("XIO15", "F.Cu", 49.24, 51.27, 53.05, 51.27),
    # ---- SCL mid B.Cu + J10 south fanout (repack) ----
    ("SCL", "B.Cu", 36.9852, 41.9382, 41.922, 37.0014),
    ("SCL", "B.Cu", 36.7585, 44.9628, 36.7585, 41.9382),
    ("SCL", "B.Cu", 50.0416, 44.4409, 50.2835, 44.199),
    ("SCL", "B.Cu", 43.6225, 51.27, 44.6376, 51.27),
    ("SCL", "B.Cu", 49.24, 52.54, 49.24, 51.3133),
    ("SCL", "B.Cu", 36.9852, 41.9382, 36.7585, 41.9382),
    ("SCL", "B.Cu", 42.89, 53.0623, 42.89, 50.5375),
    ("SCL", "B.Cu", 42.1946, 36.7288, 41.922, 37.0014),
    ("SCL", "B.Cu", 42.89, 50.5375, 43.6225, 51.27),
    ("SCL", "B.Cu", 42.89, 49.4935, 42.89, 50.5375),
    ("SCL", "B.Cu", 42.2494, 25.4223, 42.2494, 36.674),
    ("SCL", "B.Cu", 38.0089, 46.2132, 36.7585, 44.9628),
    ("SCL", "B.Cu", 47.97, 46.5125, 50.0416, 44.4409),
    ("SCL", "B.Cu", 47.183, 53.8303, 43.658, 53.8303),
    ("SCL", "B.Cu", 48.0133, 52.54, 48.0133, 53.0),
    ("SCL", "B.Cu", 39.6097, 46.2132, 38.0089, 46.2132),
    ("SCL", "B.Cu", 28.8777, 34.0574, 36.7585, 41.9382),
    ("SCL", "B.Cu", 47.97, 50.5033, 48.78, 51.3133),
    ("SCL", "B.Cu", 49.24, 52.54, 48.0133, 52.54),
    ("SCL", "B.Cu", 42.8696, 24.8021, 42.2494, 25.4223),
    ("SCL", "B.Cu", 50.2835, 31.9145, 50.2835, 44.199),
    ("SCL", "B.Cu", 42.89, 49.4935, 39.6097, 46.2132),
    ("SCL", "B.Cu", 48.78, 51.3133, 49.24, 51.3133),
    ("SCL", "B.Cu", 48.0133, 53.0, 47.183, 53.8303),
    ("SCL", "B.Cu", 43.658, 53.8303, 42.89, 53.0623),
    ("SCL", "B.Cu", 47.97, 46.5125, 47.97, 50.5033),
    # ---- SDA pocket + south fanout (repack) ----
    ("SDA", "B.Cu", 29.5044, 32.0127, 29.5044, 22.7994),
    ("SDA", "B.Cu", 31.0075, 33.5158, 29.5044, 32.0127),
    ("SDA", "B.Cu", 32.9121, 33.5158, 31.0075, 33.5158),
    ("SDA", "B.Cu", 48.0562, 43.9541, 45.43, 46.5803),
    ("SDA", "B.Cu", 45.43, 50.5033, 46.24, 51.3133),
    ("SDA", "B.Cu", 46.24, 51.3133, 46.7, 51.3133),
    ("SDA", "B.Cu", 45.43, 46.5803, 45.43, 50.5033),
    ("SDA", "B.Cu", 46.7, 52.54, 46.7, 51.3133),
    ("SDA", "B.Cu", 47.5399, 43.4378, 48.0562, 43.9541),
    ("SDA", "B.Cu", 47.5399, 43.4378, 47.5399, 29.5123),
    # ---- VCC_3V3 J10 fanout stubs ----
    ("VCC_3V3", "B.Cu", 36.0799, 51.3133, 35.3133, 50.5467),
    ("VCC_3V3", "B.Cu", 35.3133, 50.5467, 35.3133, 46.7367),
    ("VCC_3V3", "B.Cu", 36.54, 51.3133, 36.0799, 51.3133),
    ("VCC_3V3", "B.Cu", 36.54, 52.54, 36.54, 51.3133),
]

DEL_VIAS = [
    ("SCL", 28.75, 30.9),
]

ADDS = [
    # EN north B.Cu route, y23.35 clears DRDY via (20.7,22.635)
    ("EN", "B.Cu", 26.15, 44.3834, 26.15, 23.35, 0.25),
    ("EN", "B.Cu", 26.15, 23.35, 19.9, 23.35, 0.25),
    ("EN", "B.Cu", 19.9, 23.35, 19.9, 8.8071, 0.25),
    ("EN", "B.Cu", 19.9, 8.8071, 32.4506, 8.8071, 0.25),
    # EN south F.Cu lane: orphan via -> x32.5 vert -> y51.3 lane -> J10.20 stub
    ("EN", "F.Cu", 30.6751, 44.3834, 32.5, 44.38, 0.25),
    ("EN", "F.Cu", 32.5, 44.38, 32.5, 51.3, 0.25),
    ("EN", "F.Cu", 32.5, 51.3, 56.4, 51.3133, 0.25),
    # C14.2 EN hookup (pad at (33.5,14.75), vertical pair)
    ("EN", "F.Cu", 34.8951, 13.3549, 34.9, 14.15, 0.25),
    ("EN", "F.Cu", 34.9, 14.15, 34.0, 14.6, 0.25),
    # XIO15 reroute through y47.0 (frees the y51.27 lane)
    ("XIO15", "F.Cu", 53.05, 46.8, 53.05, 47.0, 0.25),
    ("XIO15", "F.Cu", 53.05, 47.0, 49.24, 47.0, 0.25),
    ("XIO15", "F.Cu", 49.24, 47.0, 49.24, 47.45, 0.25),
]

def seg_key(net, layer, x1, y1, x2, y2):
    return (net, layer, round(x1, 4), round(y1, 4), round(x2, 4), round(y2, 4))

delset = {seg_key(*d) for d in DEL_SEGS}
delvias = {(n, round(x, 4), round(y, 4)) for n, x, y in DEL_VIAS}

def parse_blocks(txt, tag):
    out = []
    i = 0
    while True:
        j = txt.find("(" + tag, i)
        if j < 0:
            break
        d = 0
        k = j
        while k < len(txt):
            if txt[k] == "(":
                d += 1
            elif txt[k] == ")":
                d -= 1
                if d == 0:
                    break
            k += 1
        out.append((j, k + 1))
        i = k + 1
    return out

spans = []
for (s, e) in parse_blocks(txt, "segment"):
    b = txt[s:e]
    nm = re.search(r'\(net "([^"]+)"\)', b)
    ly = re.search(r'\(layer "([^"]+)"\)', b)
    at = re.search(r'\(start ([-\d.]+) ([-\d.]+)\)\s*\(end ([-\d.]+) ([-\d.]+)\)', b)
    if not (nm and ly and at):
        continue
    n, l = nm.group(1), ly.group(1)
    x1, y1, x2, y2 = map(float, at.groups())
    k1 = seg_key(n, l, x1, y1, x2, y2)
    k2 = seg_key(n, l, x2, y2, x1, y1)
    if k1 in delset or k2 in delset:
        spans.append((s, e))

for (s, e) in parse_blocks(txt, "via"):
    b = txt[s:e]
    nm = re.search(r'\(net "([^"]+)"\)', b)
    at = re.search(r'\(at ([-\d.]+) ([-\d.]+)\)', b)
    if not (nm and at):
        continue
    if (nm.group(1), round(float(at.group(1)), 4), round(float(at.group(2)), 4)) in delvias:
        spans.append((s, e))

spans.sort(reverse=True)
for (s, e) in spans:
    # keep a clean file: also swallow the preceding newline+indent
    while s > 0 and txt[s - 1] in " \t":
        s -= 1
    if s > 0 and txt[s - 1] == "\n":
        s -= 1
    txt = txt[:s] + txt[e:]

add_lines = []
for (net, layer, x1, y1, x2, y2, w) in ADDS:
    add_lines.append(
        f'  (segment (start {x1} {y1}) (end {x2} {y2}) (width {w}) '
        f'(layer "{layer}") (net "{net}") (tstamp {abs(hash((net,layer,x1,y1,x2,y2)))%100000000:08x}-0000-4000-8000-000000000000))'
    )
# insert before the final zone / end of file: append before last ')'
idx = txt.rstrip().rfind(")")
txt = txt[:idx] + "\n" + "\n".join(add_lines) + "\n" + txt[idx:]

open(PCB, "w").write(txt)
print(f"removed {len(spans)} items; added {len(add_lines)} segments")
