puji4810/coffe-scale/(commit log)

2026-09-30 pcb: s3.1 KiCad project — coffee scale main board
    Schematic, PCB layout, custom symbols/footprints (s3.1.pretty), BOM +
    JLC CPL, gerbers + fabrication zip, DRC/ERC reports, design review and
    recheck docs, testpoint map, and the routing-fixup helper scripts in
    tools/.
    [BOM-jlc.csv, BOM.csv, backup-pre-fix16.kicad_pcb, backup-ripped.kicad_pcb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]
2026-09-30 firmware: ESP32-S3 scale + ESP32-S31 Korvo remote
    Scale (esp32s3, IDF 6.0): NAU7802 ADC + adaptive-EMA/Bessel/S-G filter
    pipeline, stability/tare/2-point cal, brew timer, regression flow rate,
    zero tracking + display quantiser/latch (0.1 g steps, release on
    quantised change), IMU tilt, SoftAP + WebSocket JSON protocol, LVGL
    ST7789 screen, auto light-sleep, self-hosted web UI (wasm core +
    mirror + pour logging).
    Korvo1 remote (esp32s31, IDF >=6.1): 800x480 RGB LCD remote on the
    scale's SoftAP — weight/timer/flow/battery/tilt readout, weight+flow
    chart with dual-axis tick labels, touch buttons (tare / timer / mode /
    clear+reset / unit / sleep) with pressed feedback, offline overlay.
    RGB bou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
    [partitions.csv]
2026-09-30 mechanical: v044 enclosure model
    Current revision of the cadquery/cad build for the scale body —
    base model, top pan, raised reference variant, render + review
    scripts and reference snapshots.
    [pcb-snapshot.json]
2026-09-30 mechanical: modelling toolchain + repo aux files
    Build/render/review scripts driving the parametric models (assembly,
    pan, sealed assembly, support, dimensions), optimisation comparison
    scripts + reference snapshots, design docs (pan / support / glass &
    sealing), direnv + editor settings.
    [pcb-snapshot.json]
2026-09-30 firmware: replace Wi-Fi transport with BLE — NimBLE scale peripheral, Web Bluetooth app, Korvo central
    Scale drops SoftAP/HTTP/WebSocket for a NimBLE peripheral ("coffee-scale",
    20 Hz 20-byte state frames, command char, 3 conns, fast-then-slow adv,
    full stack teardown on light sleep). Shared wire ABI lives in
    components/scale_proto and is compiled into firmware, the WASM bindings
    and the Korvo remote verbatim. Korvo becomes a NimBLE central: passive
    scan, discover, CCCD subscribe, rescan forever. Web app gains ble.js
    (Web Bluetooth, getDevices/watchAdvertisements auto-connect, backoff
    reconnect, serialized writes) and site.sh assembles a static GitHub
    Pages site; CI builds host tests, WASM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
    [partitions.csv]
2026-09-30 web: brew library — beans, dose, ratio, saved curves, backup
    A stopped recording (auto on brew timer or manual rec) now saves a
    compact brew row into IndexedDB bound to the selected bean: curve
    (t/g/flow arrays), dose, final liquid, duration. Beans are managed in a
    details card with a per-bean default dose; the brew setup row adds a
    dose input plus a weigh button that fills it from the scale. Stats row
    shows the live liquid:dose ratio; saved brews list with 5-star rating,
    fav, replay-on-chart, delete; backup exports/imports the whole library
    as JSON.
2026-09-30 web: sidebar nav + bean-centric library with inline curve details
    Drawer (☰ / left-edge swipe) splits the app into pages: weigh, beans,
    calibrate, data. Calibration wizard and backup moved off the weigh page.
    Beans are an accordion — each bean carries brand/variety/dose/note meta
    and its brews; expanding a brew shows the saved curve on the left and
    its data + a tasting note ("甜感不足…") on the right. Ratings/favs/
    delete live on the brew row, per-brew JSON export in the detail pane.
2026-09-30 web: UI overhaul — aluminium/graphite themes, hardware-style keys, Chinese UI
    Follows system light/dark; device mirror sits in an LCD bezel with raised
    keys below. Controls now reflect device state (timer label, mode/unit
    segments), disable while offline, and add timer reset. confirm() dialogs
    replaced by tap-twice confirm, feedback moved to page-local toasts, drawer
    replaced by bottom tabs / desktop rail, calibration as numbered steps.
    Vendors Barlow Semi Condensed (OFL) and bumps the SW cache to v4.
2026-09-30 web: reject pan impacts and smooth flow in charts; tie recording to the brew timer
    Impacts (stirring, setting a cup down) swung raw weight by tens of grams
    and pinned flow at ±30 g/s; kettle/drip noise made the 1 s device flow
    jittery. flow.js flags local line-fit outliers, bridges them, and derives
    flow from a 2 s centred regression at render time — stored data stays raw
    so old brews benefit. Recording now starts/pauses/saves with the timer and
    uses timer time as the x axis; the separate record button is gone.
2026-09-30 firmware: Kalman flow estimator with impact rejection; raw capture + host replay
    A real 80 Hz capture showed pan impacts (cup on/off, taps) pinning the
    1 s regression flow at ±30 g/s. flow_kf (8 Hz Butterworth prefilter →
    constant-velocity Kalman, innovation gate with rewind/hold/re-anchor)
    cuts event peaks to <9 g/s while matching pour means, and shortens the
    90% rise from ~0.83 s to ~0.66 s. The accelerometer barely sees pan
    events (load cell isolates the PCB), so rejection is weight-based.
    Tooling: 'r' console key streams raw W/A/E/C lines (accel now polled at
    100 Hz, feed_accel still decimated to 20 Hz); tools/capture.py records,
    `xmake run replay` runs a capture through the C++ pipe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
    [app_main.cpp, capture.py, filters.hpp, flow_kf.hpp, replay.cpp, replay_core.hpp, scale.hpp, telemetry.hpp]
2026-09-30 web: revert client-side chart denoising — firmware now ships clean flow
2026-09-30 firmware: split impact detection from flow tracking; robust sampling
    The old single-q estimator couldn't be sped up without tracking
    impacts too (q=80 halves t90 but triples event peaks). Detection and
    following now run on separate evidence:
    - `fast` (16 Hz) channel feeds detection only: innovation trips on
    either channel, plus a windowed-mean jump test that accepts a clean
    line (sustained steep pour) but trips on a kink (mass step).
    - Tracking runs dynamic q: a same-sign innovation run + clean window
    slope that disagrees with f_ snaps f_ to the fit (bounded) and boosts
    until settled; a boost-confirmed slope then rides a mid-level
    q_track so long pours don't pump. Steep claims nee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
    [app_main.cpp, flow_kf.hpp, flowbench.cpp, scale.hpp, test_flow_kf.cpp, xmake.lua]
2026-09-30 firmware: fix timestamp race, rebase timers, oscillation resume
    Review follow-ups on the estimator/sampling work:
    - adc_task: read the ISR's low timestamp word BEFORE esp_timer_get_time()
    — an edge landing mid-sequence otherwise unwraps the stamp ~71.6 min
    backwards. Also clamp stamps non-decreasing, and verify CR before
    every read (NAU7802 latches the previous conversion on a premature
    read, so a stale wake can no longer duplicate a sample).
    - flow_kf rebase: subtract every stored time unconditionally and use
    -1e9 "never" sentinels — a valid timer crossing zero stays exact in
    elapsed math, and a -1 sentinel can no longer masquerade as a live
    timestamp right after tp_ rest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
    [app_main.cpp, flow_kf.hpp, flowbench.cpp, test_flow_kf.cpp, test_scale.cpp]
2026-09-30 firmware: fix pour under-report, expiring osc score, steep re-trips
    Review of ce853be found the band clamp's positive ceiling applied to
    every un-gated sample, and min() of two noisy window fits is biased
    low — steady pours under-reported ~25% on hardware (14.2 real vs
    10.6 shown). Split it: the ceiling only runs during boost plus a
    0.35 s settle window, the negative floor stays armed, and a
    flat-signal rebound pin caps settle dips.
    The oscillation streak also never expired on its own — rest noise
    could keep it warm and pin a later 30 g/s pour at ~0. It now decays
    on elapsed time before any flip bookkeeping and only |slope|>5 g/s
    reversals count, so jitter can't build a streak.
    Two rec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
    [flow_kf.hpp, flowbench.cpp, test_flow_kf.cpp]
2026-09-30 flow_kf: persist steep evidence, snap residual flow on detected stops
    Two persistence requirements fix the restart/pause regressions seen on
    the real-device capture: a transition edge or splash spikes the fast
    fit's slope past gate_slope_gps for one or two samples, tripping the
    steep-slope gate into a window full of kinks that then recovers f0=0
    while the pour visibly runs. The gate now needs gate_steep_n=3
    consecutive steep samples, and the same persistence is required before
    a run is graded "steep" (a noisy fit spike otherwise forced the 0.35 s
    proof and delayed boost ~0.2 s on every resume).
    A stop used to tail ~1 s: the Kalman drains the big residual quickly
    but the last ~0.5-0.9 g/s si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
    [flow_kf.hpp, scale.hpp, telemetry.hpp, test_scale.cpp]
2026-10-01 flow_kf: resume pours through splash gates, snap stops to the fitted level
    pour-onset.txt showed two regressions: a pour whose own splash trips
    the gate resumed at f0=0 (the whole-window ramp test can never pass
    while the gate contains the trip's kink, and one counted ring flip
    vetoed the newest-half slope) and stops that tailed then rebounded to
    ~-1 g/s.
    At un-gate, when the strict triple-agreement path can't hold, fit the
    post-transient window (gate span minus its leading 0.12 s) on both
    channels — both clean, positive, and consistent with the newest half —
    and resume at min(half, pre-fit). A sustained wiggle flips inside the
    window and fails the residual bound; the handling gates in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
    [flow_kf.hpp, replay_core.hpp, test_flow_kf.cpp, test_replay.cpp]
2026-10-01 firmware: physical zero tracking, windowed display hold, latched-zero stops
    The zero tracker used to hunt the post-tare residual, so a lifted brew
    server or a tared container coming off read as "drift" and got eaten —
    and brew mode had to freeze it entirely to stay safe. It now observes
    physical gross weight before tare: initial empty evidence and slow
    empty-pan drift are authorised by the pan's own history, real small
    loads freeze it, and a large unload near the saved empty reference
    restores a bounded residual in either mode. Tare keeps the physical
    zero, so removing a tared container correctly shows negative.
    The old display latch (stable-system OR calm-digit freeze) is replaced
    by wei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
    [app.hpp, flow_kf.hpp, scale.hpp, test_flow_kf.cpp, test_replay.cpp, test_scale.cpp, test_weight_display.cpp, weight_display.hpp]
2026-10-01 web: hard-floor the weight axis at 0 so negative dives don't re-range
    The weight axis used a soft 0 min, so lifting a tared container pulled
    the whole scale into negative numbers. The flow axis is deliberately
    fixed (-10..40 g/s), so the amber curve kept its pixel position while
    every label around it went negative — the resting flow line visually
    "started" below zero.
    min.hard=0 makes 0 an absolute floor: negative weight clips at the
    plot's bottom edge, the tick labels stay >=0, and the fixed flow
    baseline keeps its meaning. Verified against the vendored uPlot range
    function: data -85..50 now ranges [0,50] instead of [-100,50], and
    resting/brew views are unchanged.
2026-10-01 web: wake lock, pour auto-timer, ghost reference + brew compare
    - screen Wake Lock while connected; re-acquires when the tab returns
    - "注水自动计时" toggle (default on): sustained >1.5 g/s flow while the
    timer is idle starts it — brewing without the timer records nothing;
    re-arms only after ~2 s of quiet flow so a reset can't re-fire on slosh
    - dashed ghost overlays the selected bean's ♥/latest brew on the live
    chart, anchored to brew-timer t=0 (projected back, so reconnecting
    mid-brew still aligns); series merge into one x column via null gaps
    - brew detail gains a compare select overlaying a second brew's curve
    - bean card: 处理法/庄园 fields, datalist suggestions o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
2026-10-01 web: fit mirror + chart on one phone screen; un-stick the header
    The sticky header followed every scroll and covered content — it's now
    a plain document-flow element (the mirror already has its own connect
    button). The mirror canvas was width:100% of a single column, so in
    landscape it alone exceeded the viewport.
    Phones now cap the bezel near its 320 px native width, and a short
    landscape viewport (<=640 px tall, <960 px wide) gets the two-column
    layout: the control column scrolls while the chart panel stays pinned
    at the top and sized to the viewport.
2026-10-02 web: bean-label scanner — on-device PP-OCRv4 in a worker, WebGPU or WASM
    Phone camera live-preview runs text detection continuously; tapping 识别
    warps each box and runs the recognizer, then keyword tables map the text
    onto bean fields and fuzzy-match the existing library. ort + models lazy-
    download once (~42 MB) and the SW caches them on miss, so the scale's MCU
    never sees a pixel and repeat scans work offline. vendored assets are
    gitignored + fetched in the pages workflow.
2026-10-02 firmware: freeze the model across sleep; extract debounced button_press
    prepare_sleep pauses the brew timer at the request (before peripherals
    tear down), wake() resumes the model clock, and feed()/tare_long drop
    input while asleep so a stale release can't start a brew mid-sleep.
    Button debounce/hold moves into a testable unit whose reset() blocks a
    key still held at wake; queued presses are flushed on both boundaries.
    [app.hpp, app_main.cpp, button_press.hpp, test_app.cpp, test_button_press.cpp]
2026-10-02 flow_kf: veto stop snaps while a fitted pour trend continues
    A tightly fitted longer positive trend contradicts the candidate stop
    while the fast channel is flat or recovering, so a pour's weight ripple
    can no longer masquerade as a stop and snap the readout into the zero
    band. Regression replays the 2026-10-01 exported brew where the proxy
    latched zero for 212.5 ms mid-pour; a synthetic 3 g/s pour + ripple case
    checks continuity and that a real stop still lands.
    [brew-continuous-weight.csv]
2026-10-02 web: append-rescan fields, batch bean/brew ops, long-press reorder
    - scan.js: repeated 识别文字 appends — OCR lines dedupe-merge across
    shots, parsed fields only fill inputs left empty, note segments merge;
    重拍 resets the form. Call side now wraps worker messages with a
    per-request watchdog and respawns a crashed worker (onerror +
    onmessageerror) so 识别中… can no longer hang the panel.
    - beans page: long-press any row enters selection mode (tap toggles);
    toolbar offers 全选 / 归档到…(batch beanId reassign) / 删除 (armed
    confirm; deleting a bean unfiles its brews) / 完成. Keeping hold and
    dragging reorders beans — order persists in localStorage('beanO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
2026-10-02 web: fix scanner hangs and reduce OCR retry latency
    Isolate camera sessions and stale worker replies, serialize inference and
    cancel closed-session work. Restore ready status on camera reopen and bound
    worker recovery instead of leaving scans stuck indefinitely.
    Canonicalize text-rectangle orientation: equivalent minimum-area edges could
    rotate crops 180 degrees, producing weak reads and repeated useless retries.
    Read all lines once before sharing a frame-wide retry budget, and fetch the
    optional v4 recognizer off the scan's critical path. Dispose tensors even on
    failed inference and reduce preview resolution while retaining read detail.
    Validation: OCR/parse and real-model checks, 13 scan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
2026-10-02 web: isolate results between consecutive label scans
    Reset fields, OCR lines, bean matches and overlays on open and each new
    recognition. Parse only the current frame instead of appending earlier
    labels and preserving already-filled fields, which could save the previous
    bean after scanning a different label.
    Cancel pending work on retake and track each scan generation through album
    selection and image decoding so stale replies cannot restore older results
    or unlock the current scan. Exercise the actual bean parser in scanner tests.
    Validation: all 20 scanner/worker regression tests, OCR real-model and parser
    checks, BLE tests, WASM smoke checks and static-site assembly pass. New cases
    cove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
2026-10-02 web: icon tabbar + landscape side rail, bean picker sheet, brew focus view
    Occlusion fixes: the fixed bottom tabbar ate the landscape viewport and
    rode above the soft keyboard — phones now get a slim icon rail in
    landscape, and the bar slides away while typing. Selects get a drawn
    chevron; the weigh-page bean select becomes a searchable bottom sheet
    with recent-first ordering and inline create; datalists become a shared
    chip popover (iOS-friendly). Brand chips gain a real add button and
    undoable delete; brew delete gets undo too.
    Polish: numeric fields get hold-to-repeat steppers, bigger star/fav tap
    targets with a pop, haptic ticks on commands, animated accordion folds,
    two-line bean car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
2026-10-03 firmware: spread VBAT sampling + piecewise Li-ion curve
    The 9-read median burst ran back-to-back in ~100 us, so it landed
    wholly inside or outside periodic BLE/LCD load sags on VBAT and the
    percent flipped ~10% between two plateaus. Spread 13 reads over ~100 ms
    (8 ms apart, spans >=2 conn intervals), keep the median, slow the EMA.
    Also replace the 3.3..4.15 V linear placeholder with a piecewise
    resting-voltage curve so mid-charge reads aren't ~10% optimistic.
    [app_main.cpp]
2026-10-03 firmware: correct VBAT for charger hold-up while charging
    TP4057 holds the terminal ~80 mV above the cell's resting voltage, so
    unplugging produced a visible ~7% step. Estimate against vbat-80 mV
    while charging — crude but removes most of the discontinuity.
    [app_main.cpp]
2026-10-03 web: trim 20 Hz UI churn, gate offscreen work, misc fixes
    The frame handler wrote ~15 DOM nodes and re-allocated the ghost
    column every BLE frame; identical writes still mark nodes dirty. Cache
    same-value text/style/class writes, keep the ghost column parallel to
    x/w/f (per-point interpolation appends in O(1); resample only runs
    when the brew or its anchor changes), and skip all DOM work while the
    tab is hidden — recording and the pour auto-timer keep running, one
    redraw flushes on return. Target-hit buzz stays ahead of the gate so
    it still fires off-screen.
    Bean search re-read IndexedDB and rebuilt the whole accordion per
    keystroke; renderBeans now splits load vs paint so cached-state ed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
2026-10-03 web: smarter scan re-reads + field capture, input fixes, UI polish
    Scanner: a re-识别 no longer wipes fields the user already edited —
    userTouched tracks typed/tap-filled inputs and only untouched fields
    get refilled (重拍 and reopen still do a full reset for a new label).
    After a scan the tap-to-fill target moves to the first empty field.
    The read path prefers ImageCapture.takePhoto (finished autofocus +
    full sensor resolution) with a video-frame fallback, and asks the
    track for continuous focusMode where offered.
    Parsing: net-weight/roast-date regexes retry on an O→0 digit copy
    (OCR loves 2026-1O-02); new note-side patterns for roast level
    (中烘/light roast), altitude (1800m), p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
2026-10-03 web: brand chips get roaster tints, counts, and tap-to-filter
    Each brand name hashes to a stable hue (brandHue) — chips render as
    tinted pills via color-mix so they stay subtle in both themes, carry
    the bean count under that brand, and tapping one filters the list
    (the search box surfaces so the filter is clearable). The same hue
    shows up as a dot next to the brand on every bean head and in the
    picker sheet. The add-brand input is now a dashed ghost chip that
    solidifies and widens on focus or once it has content.
    Brands typed into a bean or read off a label now join the preset list
    on their own — the sugg popover and OCR lexicon both draw from it, so
    managing it by hand was mostly busyw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
2026-10-03 web: brew CSV export, bean sort picker, touch cursor readout, update toast
    - data page: one-click brew CSV (BOM + escaping, dose/ratio/duration,
    rating/fav/note plus derived first-drop / avg / peak flow)
    - brew detail shows derived stats from raw t/w/f — nothing stored
    - bean library sort select (manual / recent / name / avg rating),
    persisted; drag-reorder stays manual-only
    - saved-brew plots get the live chart's floating cursor readout
    (time + g + g/s + reference); horizontal touch-drag scrubs,
    pan-y keeps vertical scrolling native
    - SW update: controllerchange after a deployed update toasts
    "新版本已就绪 · 刷新" instead of silently swapping caches;
    hourly reg.update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
2026-10-03 web: brand rail scrolls, theme cycler lands in the header
    - .brand-mgr is now a single-line horizontal rail — chips were wrapping
    into a ragged stack and shoving the search box down
    - sun/moon/auto button next to 连接秤 cycles the theme; the 数据页
    select stays in sync via shared applyTheme()
    - active chip scrolls into view; bchip gets flex:none (contents parent
    + overflow:hidden would otherwise shrink-clip it)
2026-10-03 web: stop models re-downloading — persist storage, stall-not-cap fetches
    - navigator.storage.persist(): the ~50 MB OCR cache sat in the
    best-effort bucket — the first thing evicted under storage pressure
    - fetchBuf used a flat 30 s timeout: a 25 MB model on a slow link can
    never finish, the aborted response never reaches Cache Storage, and
    every scan restarts the same download. Now a 45 s no-bytes stall bound.
    - scan warmTimer 45 s → 240 s: killing the worker mid-warm made every
    scan reopen and replay the whole download progress
2026-10-18 Simplify live flow estimation and fit saved brew curves
    Replace the gated flow state machine with a fixed 1.2-second weight regression and publication smoothing. Fit completed brews from weight on reset, retain device flow for comparison, and improve flow visibility and landscape focus controls.
    Validation: isolated staged tree passes 113 host tests, saved-brew flow regressions and BLE tests. Full workspace also passed 116 host tests, ESP32-S3 and WASM builds, smoke tests, and browser layout/reset/offline checks.
2026-10-18 Add deep-sleep standby with retained scale state
    Default standby to deep sleep, wake through LIS2DW12 double-tap or MODE, and restore calibration, tare, units, mode and paused timer from RTC memory. Serialize sensor shutdown and resume, put the LCD into sleep, and expose power diagnostics with a configurable light-sleep fallback.
    Include standby and driver regressions, power behavior documentation, and the next-revision power design notes. Validation: the isolated staged tree passes all 116 host tests; the full firmware was successfully built for ESP32-S3.
